vistorx/CatWandConnect/docs/home-assistant.fr.md

# Configurer Home Assistant

Ce guide facultatif ajoute le robot à Home Assistant, avec un tableau de bord tout prêt.

CatWandConnect fonctionne sans Home Assistant. Si tu l'utilises, le robot peut y apparaître comme un appareil avec un interrupteur de session de jeu, sa durée et l'heure à laquelle elle se termine, un bouton Ranger, son activité, et la position et la vitesse maximale de chaque axe, prêt pour tes tableaux de bord et tes automatisations.

Il y a deux façons de le connecter. Choisis-en une, configure-la, puis copie le [tableau de bord tout prêt](#tableaux-de-bord-tout-prêts) qui va avec.

## Ce qu'il te faut

| Quoi | Remarques |
|---|---|
| Un Home Assistant qui tourne | 2026.10 ou plus récent pour l'intégration native ; n'importe quelle version récente pour la connexion MQTT. |
| HACS, ou un broker MQTT | [HACS](https://hacs.xyz/) pour l'intégration native, ou un broker MQTT (l'app Mosquitto broker) pour la connexion MQTT. |
| Le robot sur ton Wi-Fi | Installé à l'[étape 3](install.fr.md), sur le même réseau que Home Assistant. |

Rien à acheter pour cette étape. **[Liste complète des pièces →](bom.fr.md)**

<!-- video: connecting the robot to Home Assistant -->
Photos et vidéo bientôt.

## Choisir ta connexion

| | Intégration native | Connexion MQTT |
|---|---|---|
| **Comment ça marche** | Home Assistant trouve le robot sur ton réseau et lui parle directement. | Le robot et Home Assistant s'échangent des messages par un *broker* MQTT qui tourne à côté de Home Assistant. |
| **Il te faut** | [HACS](https://hacs.xyz/), Home Assistant 2026.10 ou plus récent, le firmware 0.2.0-beta.2 ou plus récent sur le robot. | Un broker MQTT (l'application Mosquitto broker). Marche avec tout Home Assistant récent et toutes les versions du firmware. |
| **Installation** | 5 minutes environ : installer depuis HACS, cliquer sur **Ajouter** (et saisir le code PIN des réglages s'il y en a un). | Une dizaine de minutes : installer le broker, créer un utilisateur, ajouter l'intégration MQTT, saisir le broker dans le robot. |
| **Noms des entités** | Dans la langue de Home Assistant (français ou anglais). | En anglais. |
| **Idéal pour** | La plupart des propriétaires, surtout si tu n'utilises pas MQTT. | Ceux qui utilisent déjà MQTT (Zigbee2MQTT, Tasmota…), ou qui ne veulent pas de HACS. |

Les deux donnent les mêmes entités, suivent les mêmes règles de sécurité et restent sur ton réseau local, sans cloud. La connexion MQTT ne va pas disparaître : si elle marche déjà chez toi, garde-la.

> [!WARNING]
> N'utilise qu'une seule connexion par robot. Avec les deux, Home Assistant affiche le robot deux fois, comme deux appareils, et le second jeu d'entités reçoit des identifiants qui finissent par `_2` (`button.catwandconnect_stow_2`), que les tableaux de bord tout prêts et les automatisations ci-dessous n'utilisent pas. Pour changer, retire d'abord l'ancienne : pour la connexion MQTT, décoche **Activé** dans Réglages → Réseau → Home Assistant sur le robot, puis supprime l'appareil dans Home Assistant ; pour l'intégration native, supprime son entrée dans **Paramètres → Appareils et services → CatWandConnect**.

## Intégration native

L'intégration native s'installe avec [HACS](https://hacs.xyz/), la boutique communautaire de Home Assistant, depuis son propre dépôt, [`vistorx/ha-catwandconnect`](https://github.com/vistorx/ha-catwandconnect). Elle ne demande ni broker ni utilisateur en plus.

### Avant de commencer

- **Home Assistant 2026.10 ou plus récent** : **Paramètres → À propos** affiche la version.
- **HACS installé** : si **HACS** n'est pas dans la barre latérale de Home Assistant, suis d'abord le [guide d'installation de HACS](https://hacs.xyz/docs/use/) (en anglais).
- Le robot **installé et sur ton Wi-Fi** ([Installer le logiciel](install.fr.md)), sur le même réseau que Home Assistant, avec le **firmware 0.2.0-beta.2 ou plus récent** : sa page Infos (Réglages → Robot → Infos) affiche la version. Pour le mettre à jour, voir [Mettre à jour](install.fr.md#mettre-à-jour-compiler-depuis-les-sources).
- Un compte **administrateur** dans Home Assistant.

### 1. Installer l'intégration depuis HACS

1. Ouvre **HACS** dans la barre latérale.
2. Clique sur les trois points en haut à droite → **Dépôts personnalisés**.
3. Remplis :
   - **Dépôt** : `https://github.com/vistorx/ha-catwandconnect` ;
   - **Type** : **Intégration**.
4. Clique sur **Ajouter**, puis ferme la fenêtre.
5. Cherche **CatWandConnect** dans HACS, ouvre-le et clique sur **Télécharger**, puis encore sur **Télécharger** pour confirmer la version.
6. Redémarre Home Assistant : **Paramètres → Système**, l'icône d'alimentation en haut à droite → **Redémarrer Home Assistant**. (HACS affiche aussi une réparation *Redémarrage requis* dans **Paramètres**.)

HACS te propose tout seul les mises à jour de l'intégration quand une nouvelle version sort.

<!-- screenshot: Intégration native, step 1 -->

### 2. Ajouter le robot

1. Va dans **Paramètres → Appareils et services**.
2. En général, le robot attend sous *Découverts*, sous son nom : clique sur **Ajouter**, puis **Valider**.
3. S'il n'y est pas : **Ajouter une intégration** en bas à droite, cherche **CatWandConnect**, et saisis l'adresse du robot : son adresse `.local` (affichée dans Réglages → Réseau, par exemple `catwandconnect-3f9a.local`) ou son adresse IP, par exemple `192.168.1.20`.
4. **Code PIN des réglages** : si tu en as défini un dans les Réglages du robot, Home Assistant le demande une fois. Sans code PIN, il n'y a rien à saisir. Un code incorrect est signalé et tu peux réessayer ; après trop d'essais, attends le temps affiché.
5. Choisis une pièce si tu veux, puis **Terminer**.

Si le firmware du robot est trop ancien, l'ajout s'arrête avec *Le firmware de ce robot est trop ancien pour l'intégration* : [mets le robot à jour](install.fr.md#mettre-à-jour-compiler-depuis-les-sources) en 0.2.0-beta.2 ou plus récent, puis ajoute-le à nouveau.

Le robot n'est ajouté qu'une fois, même s'il est découvert de nouveau ; quand ta box lui donne une nouvelle adresse IP, l'intégration le suit.

<!-- screenshot: Intégration native, step 2 -->

### 3. Vérifier ses entités

Va dans **Paramètres → Appareils et services → CatWandConnect**, puis sur l'appareil du robot. Sa page liste ces entités, nommées dans la langue de Home Assistant :

| Entité | Type | Rôle |
|---|---|---|
| Ranger | Bouton | Range la baguette et relâche les servos. Passe avant toute autre commande. |
| Position horizontale, Position verticale | Nombre (degrés) | Indique où se trouve chaque axe. Changer la valeur déplace l'axe à cet endroit, à la vitesse du pilotage manuel, dans les limites de course. |
| Vitesse maximale horizontale, Vitesse maximale verticale | Nombre (10–360 °/s) | Le même réglage que dans les Réglages du robot. Une vitesse maximale inférieure ou égale à la vitesse minimale ramène la minimale au dixième de la nouvelle maximale. |
| Activité | Capteur | `idle`, `manual`, `stowing`, `calibrating`, `tuning_speed` ou `playing` (affichés *Au repos*, *Pilotage manuel*… à l'écran). |
| Session de jeu | Interrupteur | Allumé, il lance une session de jeu pour la durée de session ; éteint, il l'arrête et range la baguette. Il est allumé tant qu'une session tourne, qu'elle ait été lancée depuis Home Assistant ou depuis l'interface du robot, et s'éteint tout seul à la fin de la session. Refusé, avec un message qui dit pourquoi, tant que le robot n'est pas calibré, et pendant un rangement, une calibration ou un réglage de vitesse. |
| Durée de session | Nombre (1–60 min) | La durée de la prochaine session de jeu, la même valeur que sur l'écran principal du robot. |
| Fin de la session de jeu | Capteur (horodatage) | Le moment où la session de jeu en cours se termine, affiché « dans 7 minutes » : Home Assistant fait le décompte tout seul. Suit chaque session, lancée depuis Home Assistant ou depuis l'interface du robot. *Inconnu* quand aucune session ne tourne. Demande une intégration plus récente que la 0.2.0. |
| Session de jeu | Événement | Se déclenche à chaque événement de session de jeu : `started` (démarrée), `ended` (la durée de session est écoulée), `stopped` (arrêtée avant la fin) ou `refused` (refusée), avec les attributs `source` (`device_interface`, `home_assistant_mqtt`, `home_assistant_native`) et `reason` (pour `stopped` : `stop`, `stow`, `manual_control`, `calibration`, `speed_tuning` ; pour `refused` : `busy`, `not_calibrated`). Infos → Journal, sur le robot, affiche les 50 derniers. Intégration 0.3.0 ou plus récente, avec un firmware qui a le journal ; avec un firmware plus ancien, elle n'est pas créée. |
| Sessions aujourd'hui | Capteur | Combien de sessions de jeu ont démarré depuis minuit. Inconnu tant que le robot n'a pas l'heure : l'intégration lui donne celle de Home Assistant en se connectant. |
| Firmware | Mise à jour | La version installée et, quand une plus récente sort sur le Canal de mise à jour du robot, la dernière version avec ses nouveautés. Home Assistant affiche alors sa notification de mise à jour habituelle ; **Installer** télécharge le bon fichier et met le robot à jour (intégration 0.2.0 ou plus récente). Refusé pendant une session de jeu ou une calibration. |

Les entités se mettent à jour en moins d'une seconde quand quelqu'un utilise le joystick ou l'écran du robot. Quand le robot est éteint ou perd le Wi-Fi, elles apparaissent comme indisponibles, et reviennent toutes seules à son retour. La page de l'appareil montre aussi le modèle, la puce et la version du firmware du robot, et un lien **Visiter** vers son interface.

**Quand tu changes le code PIN du robot**, Home Assistant te demande le nouveau : le robot apparaît en haut de **Paramètres → Appareils et services** avec **Reconfigurer**. Clique dessus et saisis le nouveau code PIN.

Les commandes venant de Home Assistant suivent les mêmes règles de sécurité que le téléphone : limites de course, limites de vitesse et priorités. Rien depuis Home Assistant ne peut pousser la baguette au-delà de ses limites, et le rangement ne peut pas être interrompu.

<!-- screenshot: Intégration native, step 3 -->

## Connexion MQTT

Le robot parle à Home Assistant par **MQTT**, un petit service de messages qui tourne à côté de Home Assistant (le *broker*). Le robot y envoie son état et y reçoit ses commandes ; Home Assistant lit et écrit les mêmes messages. Compte une dizaine de minutes :

1. [Vérifier les prérequis](#1-vérifier-les-prérequis)
2. [Installer le broker MQTT](#2-installer-le-broker-mqtt)
3. [Créer un utilisateur pour le robot](#3-créer-un-utilisateur-pour-le-robot)
4. [Ajouter l'intégration MQTT](#4-ajouter-lintégration-mqtt)
5. [Connecter le robot](#5-connecter-le-robot)
6. [Le retrouver dans Home Assistant](#6-le-retrouver-dans-home-assistant)

Tu utilises déjà MQTT (Zigbee2MQTT, Tasmota…) ? Ton broker et ton intégration sont prêts : crée un utilisateur (étape 3) et passe à l'[étape 5](#5-connecter-le-robot).

### 1. Vérifier les prérequis

- **Home Assistant OS** (un Home Assistant Green ou Yellow, un Raspberry Pi, une machine virtuelle). Pour le vérifier : **Paramètres → À propos**, ligne *Type d'installation*. Sur **Home Assistant Container** ou **Core**, il n'y a pas de menu *Applications* : installe toi-même un broker Mosquitto (par exemple son image Docker) et passe à l'[étape 4](#4-ajouter-lintégration-mqtt).
- Un compte **administrateur** dans Home Assistant.
- Le robot **installé et sur ton Wi-Fi** ([Installer le logiciel](install.fr.md)), sur le même réseau que Home Assistant.
- L'**adresse IP** de Home Assistant : **Paramètres → Système → Réseau**, sous *Adaptateur réseau*, par exemple `192.168.1.124`. Note-la pour l'étape 5. Donne-lui une adresse fixe dans ta box (une *réservation DHCP*) pour qu'elle ne change jamais.

<!-- screenshot: Connexion MQTT, step 1 -->

### 2. Installer le broker MQTT

1. Dans Home Assistant, va dans **Paramètres → Applications → Installer une application** (appelées *Modules complémentaires* avant Home Assistant 2026.2).
2. Cherche **Mosquitto broker** et ouvre-le.
3. Clique sur **Installer**, patiente, puis active **Démarrer au démarrage** et clique sur **Démarrer**.
4. Ouvre l'onglet **Journal** : au bout de quelques secondes, il doit se terminer sans erreur.

Laisse son onglet *Configuration* tel quel : le broker accepte les utilisateurs de Home Assistant, c'est ce qu'utilise l'étape 3.

<!-- screenshot: Connexion MQTT, step 2 -->

### 3. Créer un utilisateur pour le robot

Le broker refuse les connexions anonymes : le robot a besoin de son propre identifiant.

1. Active le **Mode avancé** : clique sur ton nom en bas à gauche, puis active *Mode avancé* (sinon l'onglet *Utilisateurs* est caché).
2. Va dans **Paramètres → Personnes → Utilisateurs** et clique sur **Ajouter un utilisateur**.
3. Remplis :
   - **Nom d'affichage** : `CatWandConnect` ;
   - **Nom d'utilisateur** : `catwandconnect` (pas `homeassistant` ni `addons` : le broker les réserve) ;
   - **Mot de passe** : un nouveau mot de passe, utilisé seulement par le robot. Note-le pour l'étape 5.
4. Laisse **Administrateur** désactivé, puis clique sur **Créer**.

Cet utilisateur ne se connecte jamais à l'interface de Home Assistant ; il permet seulement au robot de parler au broker.

<!-- screenshot: Connexion MQTT, step 3 -->

### 4. Ajouter l'intégration MQTT

C'est ce qui relie Home Assistant lui-même au broker.

1. Va dans **Paramètres → Appareils et services**.
2. En général, **MQTT** attend sous *Découverts* : clique sur **Ajouter**, puis **Valider**.
3. S'il n'y est pas : **Ajouter une intégration** en bas à droite, cherche **MQTT**, choisis **MQTT**, et confirme le broker Mosquitto.
4. **MQTT** apparaît maintenant dans la liste des intégrations, sans erreur.

Laisse *Activer la découverte* coché et le préfixe de découverte à `homeassistant` (les valeurs par défaut) : c'est là que le robot s'annonce.

<!-- screenshot: Connexion MQTT, step 4 -->

### 5. Connecter le robot

1. Ouvre l'interface du robot (son adresse `.local` ou son IP), puis **Réglages → Réseau → Home Assistant**.
2. Coche **Activé**, et remplis :
   - **Broker** : l'adresse IP de Home Assistant notée à l'étape 1, par exemple `192.168.1.124`. `homeassistant.local` marche aussi sur la plupart des réseaux, mais l'IP est plus fiable ;
   - **Port** : `1883` ;
   - **Utilisateur** et **Mot de passe** : l'utilisateur de l'étape 3.
3. Clique sur **Enregistrer**. Si un code PIN des réglages est défini, le robot le demande.
4. En quelques secondes, **État** indique **Connecté**. S'il affiche une erreur, voir [Dépannage de la connexion MQTT](#dépannage-de-la-connexion-mqtt).

Le robot se reconnecte tout seul après une coupure de courant ou un redémarrage de Home Assistant.

<!-- screenshot: Connexion MQTT, step 5 -->

### 6. Le retrouver dans Home Assistant

Va dans **Paramètres → Appareils et services → MQTT**, puis **Appareils**. Le robot apparaît sous son nom, avec les mêmes entités qu'avec l'intégration native ([listées plus haut](#3-vérifier-ses-entités)), mais nommées en anglais : Stow, Horizontal position, Vertical position, Horizontal maximum speed, Vertical maximum speed, Activity, Play session (interrupteur et événement), Session duration, Sessions today, Firmware et Play session end. Les différences :

- Horizontal position et Vertical position vont de 0 à 180° ; le robot garde l'axe dans ses limites de course.
- Une session de jeu refusée par le robot (pas calibré, occupé) remet l'interrupteur sur éteint sans message ; l'événement Play session se déclenche avec `refused` et la raison, et Infos → Journal, sur le robot, l'affiche.
- **Sessions today** reste inconnu après un redémarrage du robot tant que personne n'a ouvert sa page : en MQTT, le robot ne reçoit l'heure que du navigateur du téléphone.
- Session duration est mémorisée dès que le robot est au repos.
- Play session end (`sensor.catwandconnect_play_session_end`) est calculé par Home Assistant : le robot n'a pas d'horloge, il envoie donc le temps restant quand une session commence ou se termine, et Home Assistant l'ajoute à sa propre heure. Demande un firmware plus récent que la 0.2.1.
- **Firmware** (`update.catwandconnect_firmware`) affiche la version installée et, dès que la page du robot en a trouvé une plus récente pour son Canal de mise à jour, la dernière version avec un lien vers ses nouveautés : Home Assistant affiche alors sa notification de mise à jour habituelle. Il n'y a pas de bouton **Installer** : le robot ne peut rien télécharger lui-même. Mets à jour depuis la page du robot (le bouton **Mettre à jour** de son écran principal, voir [Mettre à jour](install.fr.md#mettre-à-jour-compiler-depuis-les-sources)) ou avec l'intégration native. La dernière version est connue après que quelqu'un a ouvert la page du robot, et oubliée quand le robot redémarre.

Quand le robot est éteint ou perd le Wi-Fi, ses entités apparaissent comme indisponibles.

<!-- screenshot: Connexion MQTT, step 6 -->

## Tableaux de bord tout prêts

Un panneau de contrôle pour le robot : un grand bouton de session de jeu (appuie pour lancer, appuie encore pour arrêter) et sa durée, Ranger, l'activité et, pendant une session, l'heure à laquelle elle se termine, la position et la vitesse maximale de chaque axe, et un bouton **Page du robot** qui ouvre la page du robot lui-même. Un appui long sur n'importe laquelle de ses cartes ouvre aussi la page du robot. Il y en a un pour chaque connexion. Celui de l'intégration native ajoute la carte joystick fournie par l'intégration ; celui de la connexion MQTT n'utilise que des cartes intégrées à Home Assistant.

1. Va dans **Paramètres → Tableaux de bord → Ajouter un tableau de bord → Nouveau tableau de bord à partir de zéro**, nomme-le, par exemple « Canne à chat », et ouvre-le.
2. Clique sur le crayon (**Modifier le tableau de bord**), puis sur les trois points → **Éditeur de configuration brute**.
3. Remplace tout par le YAML de ta connexion ci-dessous.
4. Remplace chaque `http://catwandconnect.local/` par l'adresse de ton robot (rechercher et remplacer dans l'éditeur), puis **Enregistre**. L'adresse est sur la page du robot, dans **Réglages → Réseau → Wi-Fi** : par exemple `http://catwandconnect-3f9a.local/` avec le nom par défaut. Les robots installés avant la version 0.2.1 gardent `http://catwandconnect.local/` : rien à remplacer. C'est cette adresse qu'ouvrent le bouton **Page du robot** et les appuis longs ; la page de l'appareil dans Home Assistant a aussi un lien **Visiter** vers elle.

Sur un téléphone, les sections s'empilent : la session de jeu d'abord, puis les positions et les vitesses. Pour ajouter les cartes à un tableau de bord existant, copie seulement les trois sections `- type: grid` dans une de ses vues en sections.

**Robot renommé ?** Les identifiants ci-dessous sont ceux d'un robot qui a le nom par défaut. Les identifiants des entités suivent le nom du robot : pour un robot nommé « CatWandConnect salon », remplace chaque `catwandconnect_` par `catwandconnect_salon_` (rechercher et remplacer dans l'éditeur). Les identifiants exacts sont sur la page de l'appareil, dans **Paramètres → Appareils et services**, puis **CatWandConnect** ou **MQTT**.

### Tableau de bord pour l'intégration native

Le tableau de bord de l'intégration native : session de jeu, durée et Ranger, la carte joystick, positions et vitesses maximales

<!-- ha-dashboard-native -->
```yaml
title: Canne à chat
views:
  - title: Canne à chat
    path: catwandconnect
    type: sections
    max_columns: 3
    sections:
      - type: grid
        cards:
          - type: heading
            heading: Session de jeu
            icon: mdi:cat
            badges:
              - type: entity
                entity: sensor.catwandconnect_activity
                show_state: true
              - type: entity
                entity: sensor.catwandconnect_play_session_end
                show_state: true
                visibility:
                  - condition: state
                    entity: sensor.catwandconnect_play_session_end
                    state_not: [unknown, unavailable]
              - type: entity
                entity: update.catwandconnect_firmware
                show_state: true
                visibility:
                  - condition: state
                    entity: update.catwandconnect_firmware
                    state: "on"
              - type: button
                icon: mdi:open-in-new
                text: Page du robot
                tap_action:
                  action: url
                  url_path: http://catwandconnect.local/
          - type: button
            entity: switch.catwandconnect_play_session
            name: Session de jeu
            icon: mdi:play-circle-outline
            show_state: false
            icon_height: 64px
            tap_action:
              action: toggle
            hold_action:
              action: url
              url_path: http://catwandconnect.local/
          - type: tile
            entity: number.catwandconnect_session_duration
            name: Durée de session
            features:
              - type: numeric-input
                style: buttons
            features_position: inline
            hold_action:
              action: url
              url_path: http://catwandconnect.local/
          - type: tile
            entity: button.catwandconnect_stow
            name: Ranger
            color: red
            tap_action:
              action: perform-action
              perform_action: button.press
              target:
                entity_id: button.catwandconnect_stow
            hold_action:
              action: url
              url_path: http://catwandconnect.local/
      - type: grid
        cards:
          - type: heading
            heading: Position
            icon: mdi:axis-arrow
          - type: custom:catwandconnect-joystick-card
            entity: sensor.catwandconnect_activity
          - type: tile
            entity: number.catwandconnect_horizontal_position
            name: Horizontal
            features:
              - type: numeric-input
                style: slider
            hold_action:
              action: url
              url_path: http://catwandconnect.local/
          - type: tile
            entity: number.catwandconnect_vertical_position
            name: Vertical
            features:
              - type: numeric-input
                style: slider
            hold_action:
              action: url
              url_path: http://catwandconnect.local/
      - type: grid
        cards:
          - type: heading
            heading: Vitesse maximale
            icon: mdi:speedometer
          - type: tile
            entity: number.catwandconnect_horizontal_maximum_speed
            name: Horizontal
            features:
              - type: numeric-input
                style: buttons
            features_position: inline
            hold_action:
              action: url
              url_path: http://catwandconnect.local/
          - type: tile
            entity: number.catwandconnect_vertical_maximum_speed
            name: Vertical
            features:
              - type: numeric-input
                style: buttons
            features_position: inline
            hold_action:
              action: url
              url_path: http://catwandconnect.local/
```

Le joystick marche comme celui de la page du robot : maintiens et fais glisser, la baguette suit ; lâche, elle s'arrête. Il est fourni par l'intégration (0.1.1 ou plus récente) : rien à ajouter dans *Ressources*. S'il affiche « Custom element doesn't exist », recharge la page (tire vers le bas dans l'appli) après la mise à jour. Les curseurs de position vont d'une limite de course à l'autre.

**Tu as ajouté le robot avec l'intégration 0.1.0, avec Home Assistant dans une autre langue que l'anglais ?** Ses identifiants sont dans cette langue (`switch.catwandconnect_session_de_jeu`) et les cartes affichent « Entité non disponible ». Supprime le robot dans **Paramètres → Appareils et services → CatWandConnect** et ajoute-le de nouveau (à partir de la 0.1.1, les identifiants sont toujours en anglais), ou remplace les identifiants du YAML par les tiens, visibles sur la page de l'appareil.

### Tableau de bord pour la connexion MQTT

Le tableau de bord de la connexion MQTT : session de jeu, durée et Ranger, positions et vitesses maximales

<!-- ha-dashboard -->
```yaml
title: Canne à chat
views:
  - title: Canne à chat
    path: catwandconnect
    type: sections
    max_columns: 3
    sections:
      - type: grid
        cards:
          - type: heading
            heading: Session de jeu
            icon: mdi:cat
            badges:
              - type: entity
                entity: sensor.catwandconnect_activity
                show_state: true
              - type: entity
                entity: sensor.catwandconnect_play_session_end
                show_state: true
                visibility:
                  - condition: state
                    entity: sensor.catwandconnect_play_session_end
                    state_not: [unknown, unavailable]
              - type: entity
                entity: update.catwandconnect_firmware
                show_state: true
                visibility:
                  - condition: state
                    entity: update.catwandconnect_firmware
                    state: "on"
              - type: button
                icon: mdi:open-in-new
                text: Page du robot
                tap_action:
                  action: url
                  url_path: http://catwandconnect.local/
          - type: button
            entity: switch.catwandconnect_play_session
            name: Session de jeu
            icon: mdi:play-circle-outline
            show_state: false
            icon_height: 64px
            tap_action:
              action: toggle
            hold_action:
              action: url
              url_path: http://catwandconnect.local/
          - type: tile
            entity: number.catwandconnect_session_duration
            name: Durée de session
            features:
              - type: numeric-input
                style: buttons
            features_position: inline
            hold_action:
              action: url
              url_path: http://catwandconnect.local/
          - type: tile
            entity: button.catwandconnect_stow
            name: Ranger
            color: red
            tap_action:
              action: perform-action
              perform_action: button.press
              target:
                entity_id: button.catwandconnect_stow
            hold_action:
              action: url
              url_path: http://catwandconnect.local/
      - type: grid
        cards:
          - type: heading
            heading: Position
            icon: mdi:axis-arrow
          - type: tile
            entity: number.catwandconnect_horizontal_position
            name: Horizontal
            features:
              - type: numeric-input
                style: slider
            hold_action:
              action: url
              url_path: http://catwandconnect.local/
          - type: tile
            entity: number.catwandconnect_vertical_position
            name: Vertical
            features:
              - type: numeric-input
                style: slider
            hold_action:
              action: url
              url_path: http://catwandconnect.local/
      - type: grid
        cards:
          - type: heading
            heading: Vitesse maximale
            icon: mdi:speedometer
          - type: tile
            entity: number.catwandconnect_horizontal_maximum_speed
            name: Horizontal
            features:
              - type: numeric-input
                style: buttons
            features_position: inline
            hold_action:
              action: url
              url_path: http://catwandconnect.local/
          - type: tile
            entity: number.catwandconnect_vertical_maximum_speed
            name: Vertical
            features:
              - type: numeric-input
                style: buttons
            features_position: inline
            hold_action:
              action: url
              url_path: http://catwandconnect.local/
```

Les curseurs de position vont de 0 à 180° ; le robot s'arrête à ses limites de course. Un badge **Firmware** apparaît à côté d'Activity quand une nouvelle version est disponible ; touche-le pour voir les nouveautés. La carte joystick n'existe qu'avec l'intégration native ; avec la connexion MQTT, déplace la baguette avec les curseurs ou depuis la page du robot.

## Automatisations

Dans **Paramètres → Automatisations et scènes → Créer une automatisation → Créer une nouvelle automatisation**, trois points → **Modifier en YAML**, colle l'un de ces exemples, puis **Enregistrer**. Ils marchent avec les deux connexions.

Ranger la baguette tous les soirs à 22 h :

```yaml
alias: Ranger la canne à chat le soir
triggers:
  - trigger: time
    at: "22:00:00"
actions:
  - action: button.press
    target:
      entity_id: button.catwandconnect_stow
```

Lancer une session de jeu de 15 minutes quand tu pars au travail en semaine :

```yaml
alias: Jouer avec le chat après notre départ
triggers:
  - trigger: time
    at: "08:30:00"
conditions:
  - condition: time
    weekday: [mon, tue, wed, thu, fri]
actions:
  - action: number.set_value
    target:
      entity_id: number.catwandconnect_session_duration
    data:
      value: 15
  - action: switch.turn_on
    target:
      entity_id: switch.catwandconnect_play_session
```

Recevoir une notification quand une session de jeu est refusée, avec la raison :

```yaml
alias: Prévenir quand la baguette refuse de jouer
triggers:
  - trigger: state
    entity_id: event.catwandconnect_play_session
conditions:
  - condition: template
    value_template: "{{ trigger.to_state.attributes.event_type == 'refused' }}"
actions:
  - action: notify.notify
    data:
      message: >-
        La baguette a refusé de jouer ({{ trigger.to_state.attributes.reason }}).
```

Les identifiants des entités suivent le nom du robot : `button.catwandconnect_stow` par défaut, `button.catwandconnect_salon_stow` pour un robot nommé « CatWandConnect salon ». Ils restent en anglais, et sont les mêmes avec les deux connexions ; des identifiants qui finissent par `_2` veulent dire que le robot est connecté deux fois (voir [Choisir ta connexion](#choisir-ta-connexion)). Les automatisations sur l'activité utilisent ses états `idle`, `manual`, `stowing`, `calibrating`, `tuning_speed` et `playing`, quelle que soit la langue dans laquelle Home Assistant les affiche. L'état d'une entité événement est l'heure de son dernier événement : déclenche sur tout changement et teste `event_type`, pour que deux refus de suite comptent tous les deux.

## Dépannage

### Dépannage de l'intégration native

| Problème | À vérifier |
|---|---|
| Le robot n'est pas sous *Découverts* | Ajoute-le à la main : **Ajouter une intégration → CatWandConnect**, avec son adresse IP (sur sa page Infos) ou son nom en `.local`. La découverte passe par le mDNS, qui ne traverse pas les réseaux : si Home Assistant et le robot sont sur des VLAN ou des sous-réseaux différents (un réseau IoT, un Wi-Fi invité), ajoute-le par son IP et donne au robot une adresse fixe dans ta box (une *réservation DHCP*), ou active un relais mDNS dans ton routeur. Sur Home Assistant Container, la découverte demande le réseau en mode hôte ; dans une machine virtuelle, une carte réseau en mode pont (pas en NAT). Un robot déjà ajouté n'y apparaît plus. Pour savoir si Home Assistant entend le robot, active **Activer la journalisation de débogage** sur la page de l'intégration CatWandConnect et redémarre-la : chaque annonce ajoute une ligne *Robot … announced at …* dans le journal. |
| *CatWandConnect* n'est pas dans **Ajouter une intégration** | Home Assistant n'a pas été redémarré après le téléchargement ([étape 1](#1-installer-lintégration-depuis-hacs)), ou HACS n'a rien téléchargé : ouvre HACS et vérifie que l'intégration apparaît comme téléchargée. Recharge ensuite la page du navigateur. |
| *Le firmware de ce robot est trop ancien pour l'intégration* | Le robot a un firmware plus ancien que 0.2.0-beta.2. [Mets-le à jour](install.fr.md#mettre-à-jour-compiler-depuis-les-sources), puis ajoute-le à nouveau. |
| Impossible de joindre le robot | Le robot est allumé, sur le même réseau que Home Assistant, et son interface s'ouvre dans un navigateur à l'adresse que tu as saisie. |
| Home Assistant redemande le code PIN | Le code PIN des réglages du robot a changé. Clique sur **Reconfigurer** et saisis le code PIN actuel. |
| Entités indisponibles | Le robot est éteint ou hors Wi-Fi. Elles reviennent toutes seules dans les 30 secondes environ qui suivent sa reconnexion. Si elles restent indisponibles, vérifie que l'interface du robot s'ouvre ; si son IP a changé et que la découverte ne le voit pas (autre VLAN), réserve son adresse dans ta box. |
| La session de jeu ne démarre pas | Home Assistant dit pourquoi : le robot n'est pas encore calibré, ou il est en train de se ranger, de se calibrer ou de régler une vitesse. Calibre-le depuis son écran principal. |

Pour un rapport de bug, ajoute les diagnostics de l'intégration : sur la page de l'appareil du robot, les trois points → **Télécharger les diagnostics**. Le nom de ton Wi-Fi, tes adresses et les détails du broker y sont masqués, comme dans le rapport de diagnostic.

### Dépannage de la connexion MQTT

| État dans les Réglages du robot | À vérifier |
|---|---|
| Broker injoignable | L'adresse du broker et le port `1883`, et que l'application Mosquitto broker est démarrée ([étape 2](#2-installer-le-broker-mqtt)). Mets l'IP de Home Assistant au lieu de `homeassistant.local`. |
| Le broker a refusé l'utilisateur ou le mot de passe | L'utilisateur et le mot de passe de l'[étape 3](#3-créer-un-utilisateur-pour-le-robot). Retape le mot de passe dans le robot (il n'affiche jamais celui enregistré). Le nom d'utilisateur ne peut pas être `homeassistant` ni `addons`. |
| Connecté, mais aucun appareil dans Home Assistant | L'intégration MQTT est installée ([étape 4](#4-ajouter-lintégration-mqtt)), avec la découverte activée et le préfixe `homeassistant`. |
| Entités indisponibles | Le robot est éteint ou hors Wi-Fi. Elles reviennent dans la minute qui suit sa reconnexion. |
| L'interrupteur de session de jeu revient sur éteint | Le robot n'est pas encore calibré, ou il est en train de se ranger, de se calibrer ou de régler une vitesse. Calibre-le depuis son écran principal. |

Les topics MQTT du robot sont documentés dans l'[API du robot](api.fr.md#home-assistant-mqtt). La page de l'appareil dans Home Assistant a un lien **Visiter** vers l'interface du robot (la découverte MQTT n'autorise qu'un lien par appareil, il ne peut donc pas pointer directement vers la page Aide).

### Toujours bloqué ?

Voir [Obtenir de l'aide](../SUPPORT.fr.md), ou ouvre **Aide** dans Réglages → Robot. Les bugs de l'intégration native se signalent aussi dans les [issues de CatWandConnect](https://github.com/vistorx/CatWandConnect/issues/new/choose) : choisis *Home Assistant integration (HACS)* comme domaine.

Ensuite : joue ! Toutes les fonctionnalités sont décrites dans [Fonctionnalités](features.fr.md).
