vistorx/CatWandConnect/media/discord/discord-admin-512.png

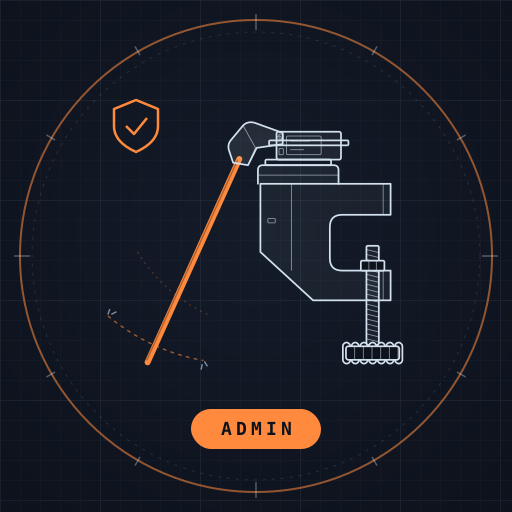
media/discord/discord-admin-512.png
