vistorx/CatWandConnect/media/social/social-preview.png

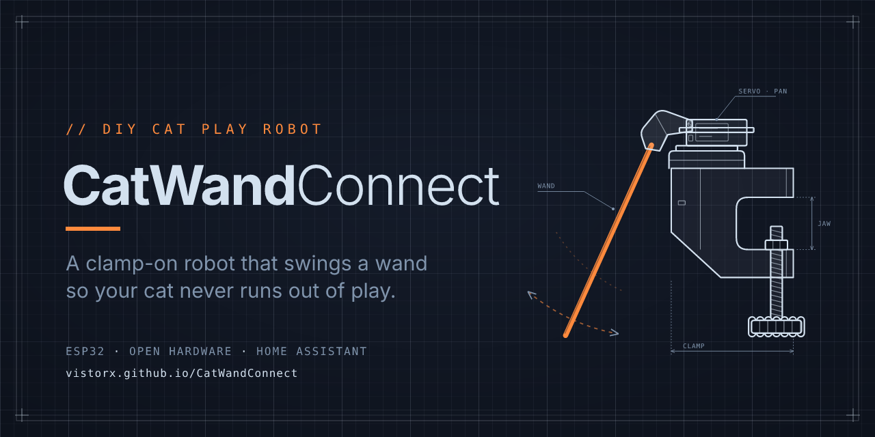
media/social/social-preview.png
