vistorx/CatWandConnect/media/video/mk2-presentation-poster.jpg

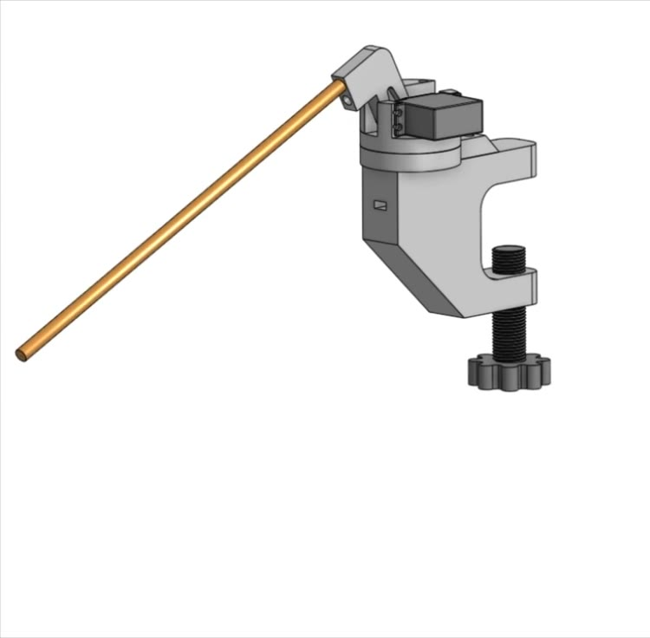
media/video/mk2-presentation-poster.jpg
