vistorx/CatWandConnect/stls/cat_playing_platform_V1/Stick support.stl

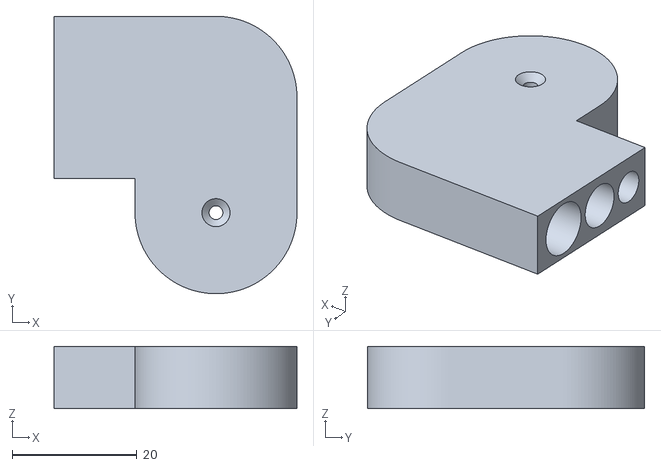
[picture p9: CAD file, 2026-10-08]
stls/cat_playing_platform_V1/Stick support.stl
39.0 x 44.5 x 10.0
