vistorx/CatWandConnect/stls/mk3/catwandconnect-mk3-clamp.stl

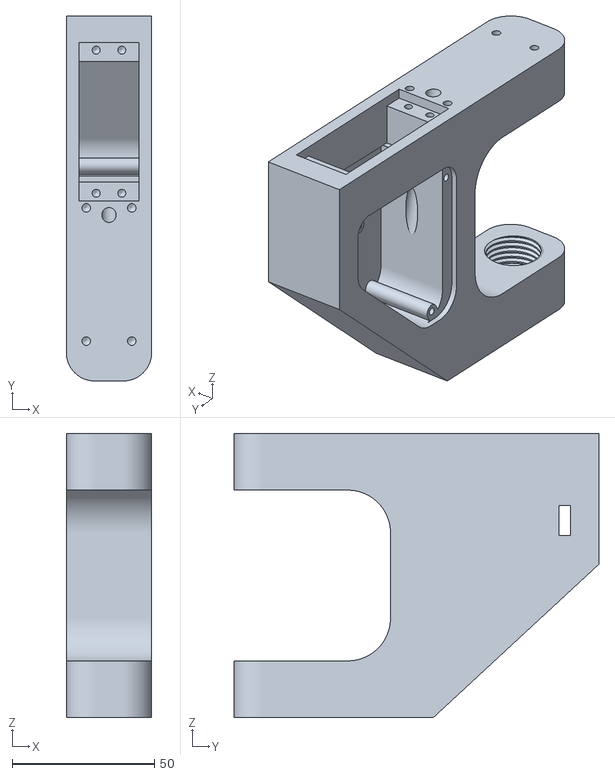
[picture p10: CAD file, 2026-10-18]
stls/mk3/catwandconnect-mk3-clamp.stl
30.0 x 128.3 x 100.0
