vistorx/CatWandConnect/cads/mk3/catwandconnect-mk3-arm.step

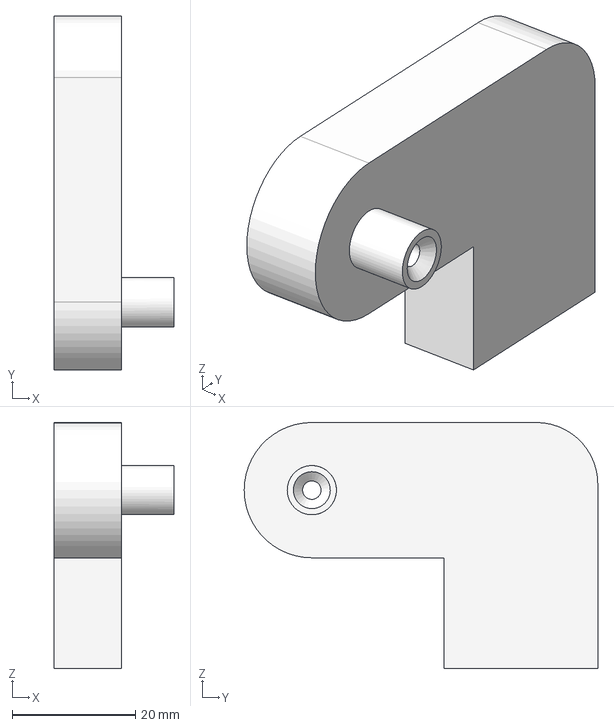
[picture p11: CAD file, 2026-10-20]
cads/mk3/catwandconnect-mk3-arm.step
19.5 x 57.5 x 40.0 mm
