vistorx/CatWandConnect/stls/cat_playing_platform_V1/CLAMP - Pad.stl

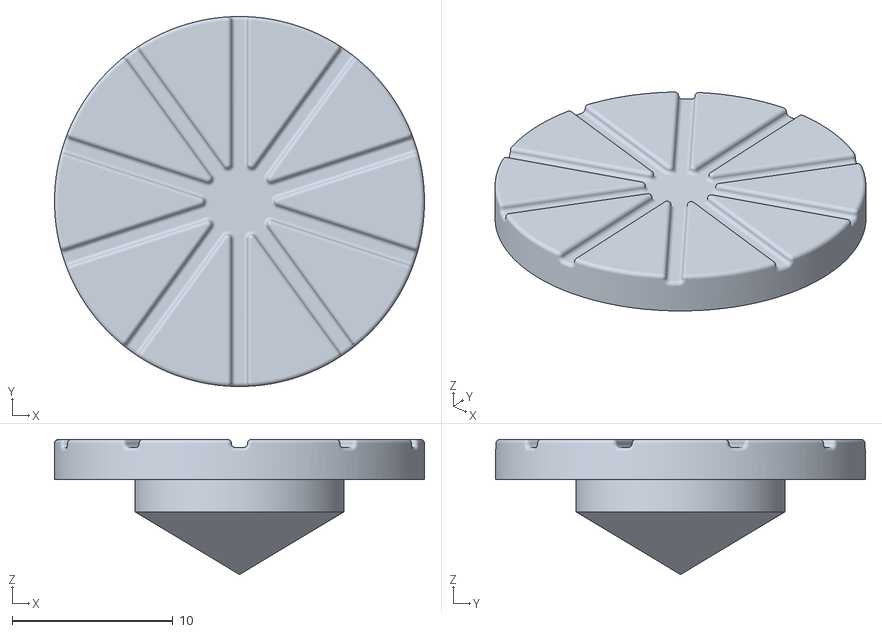
[picture p12: CAD file, 2026-10-08]
stls/cat_playing_platform_V1/CLAMP - Pad.stl
23.0 x 23.0 x 8.41
