vistorx/CatWandConnect/stls/mk3/catwandconnect-mk3.3mf

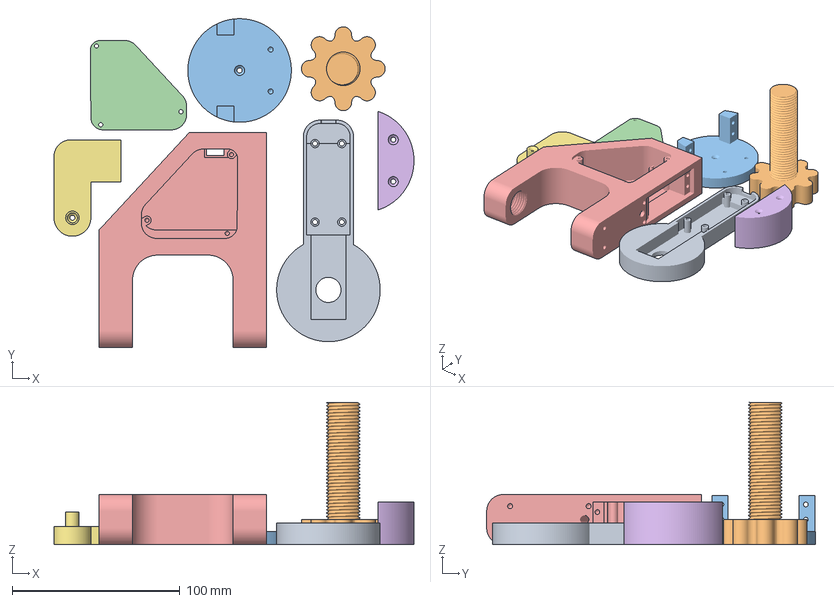
[picture p13: CAD file, 2026-10-18]
stls/mk3/catwandconnect-mk3.3mf
214.8 x 196.1 x 85.0 mm
catwandconnect-mk3-top_plate.stl
catwandconnect-mk3-screw.stl
catwandconnect-mk3-rotor_plate.stl
catwandconnect-mk3-door.stl
catwandconnect-mk3-clamp.stl
catwandconnect-mk3-bearing_holder.stl
catwandconnect-mk3-arm.stl
