vistorx/CatWandConnect/stls/cat_playing_platform_V1/Part Studio 1 - Part 2.stl

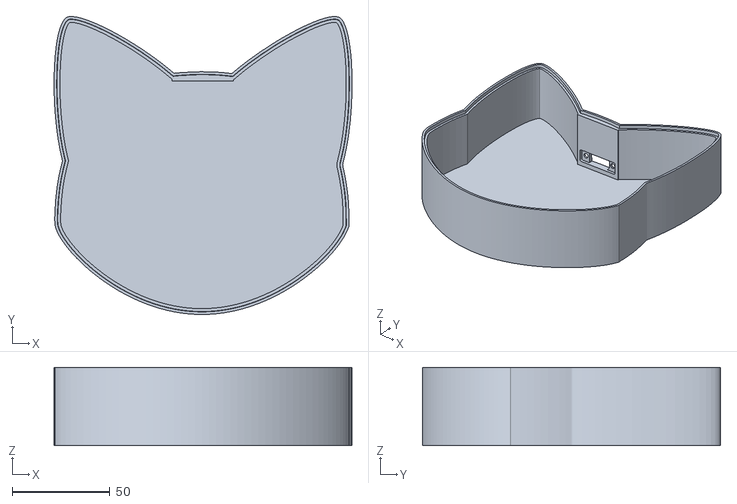
[picture p14: CAD file, 2026-10-08]
stls/cat_playing_platform_V1/Part Studio 1 - Part 2.stl
152.4 x 152.4 x 40.0
