vistorx/CatWandConnect/stls/mk3/catwandconnect-mk3-top_plate.stl

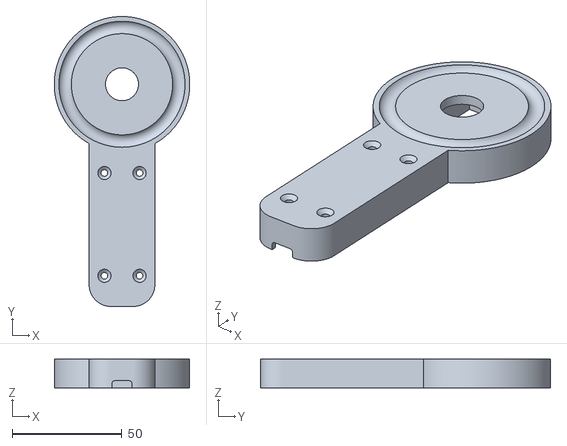
[picture p15: CAD file, 2026-10-18]
stls/mk3/catwandconnect-mk3-top_plate.stl
61.8 x 132.2 x 13.0
