vistorx/CatWandConnect/stls/cat_playing_platform_V1/Part Studio 1 - Part 3.stl

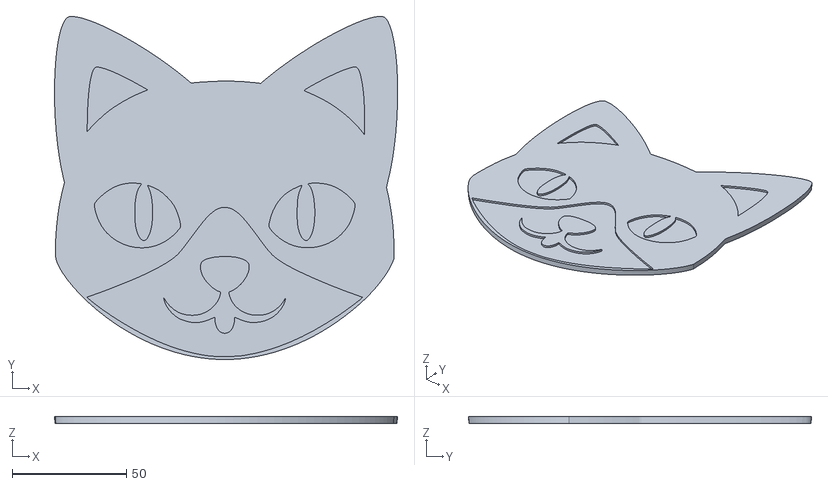
[picture p16: CAD file, 2026-10-08]
stls/cat_playing_platform_V1/Part Studio 1 - Part 3.stl
149.8 x 149.9 x 3.00
