vistorx/CatWandConnect/stls/mk3/catwandconnect-mk3-bearing_holder.stl

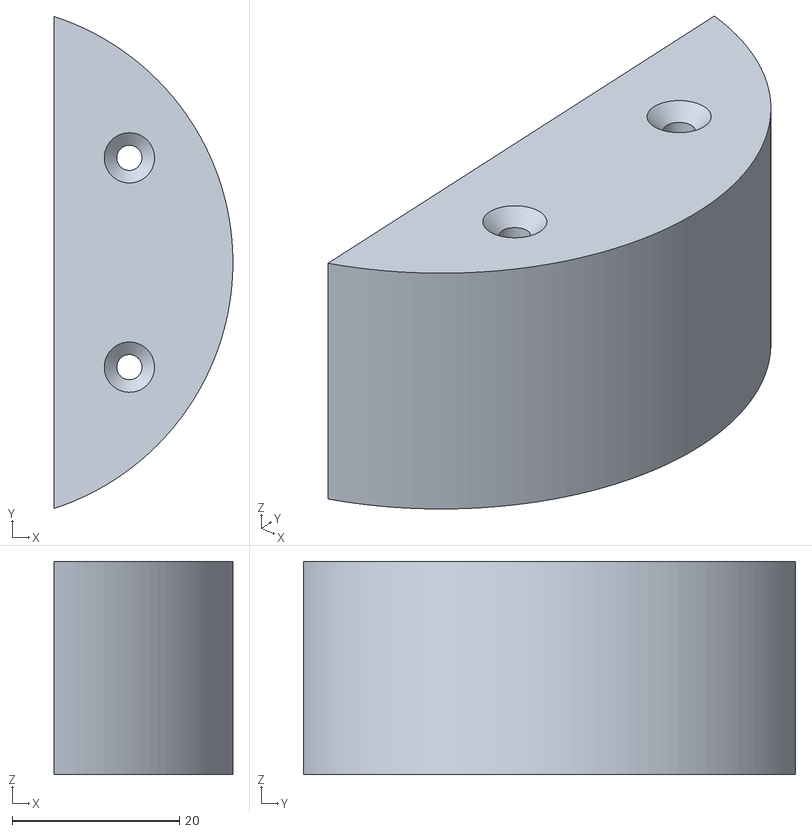
[picture p17: CAD file, 2026-10-17]
stls/mk3/catwandconnect-mk3-bearing_holder.stl
21.4 x 58.8 x 25.5
