vistorx/CatWandConnect/cads/mk3/catwandconnect-mk3-rotor_plate.step

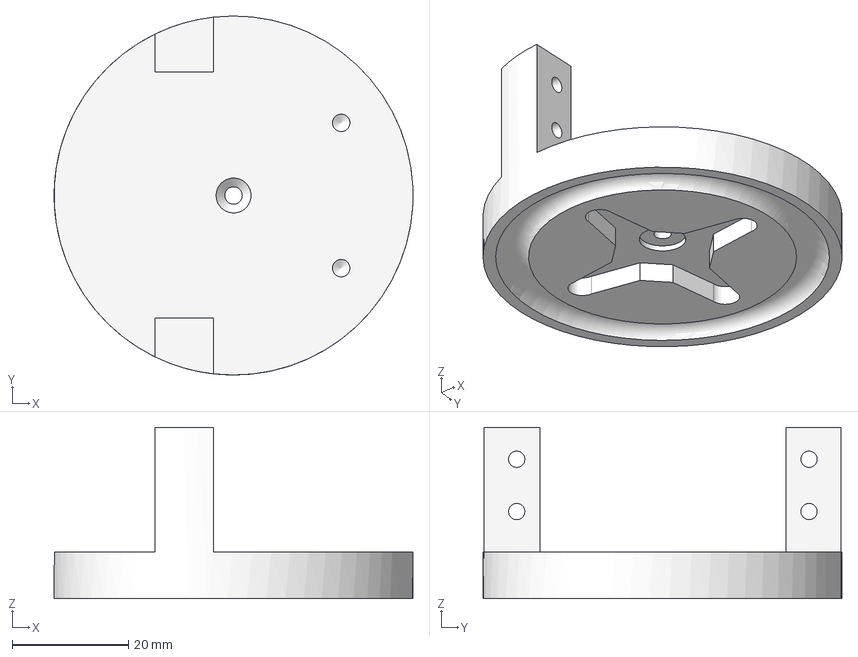
[picture p18: CAD file, 2026-10-20]
cads/mk3/catwandconnect-mk3-rotor_plate.step
61.8 x 61.8 x 29.5 mm
