vistorx/CatWandConnect/stls/cat_playing_platform_V1/CLAMP - Clamp.stl

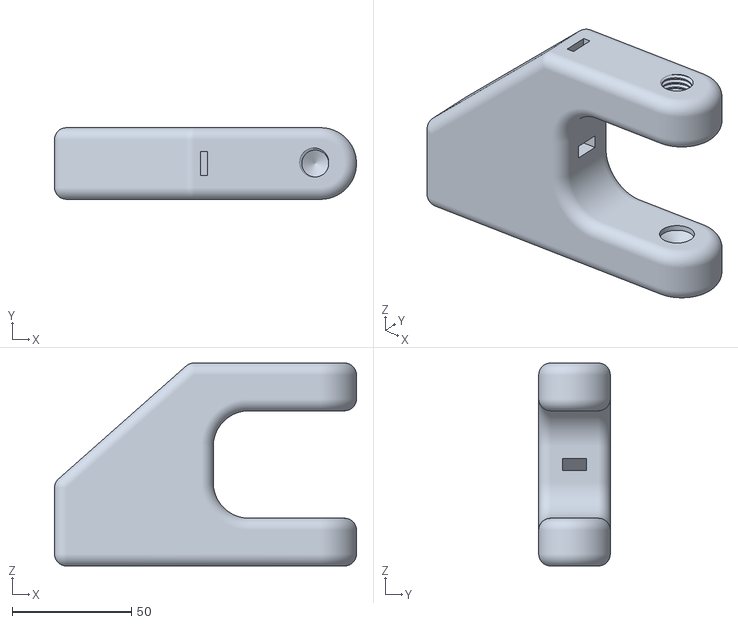
[picture p19: CAD file, 2026-10-08]
stls/cat_playing_platform_V1/CLAMP - Clamp.stl
126.5 x 30.0 x 85.0
