vistorx/CatWandConnect/stls/mk3/catwandconnect-mk3-door.stl

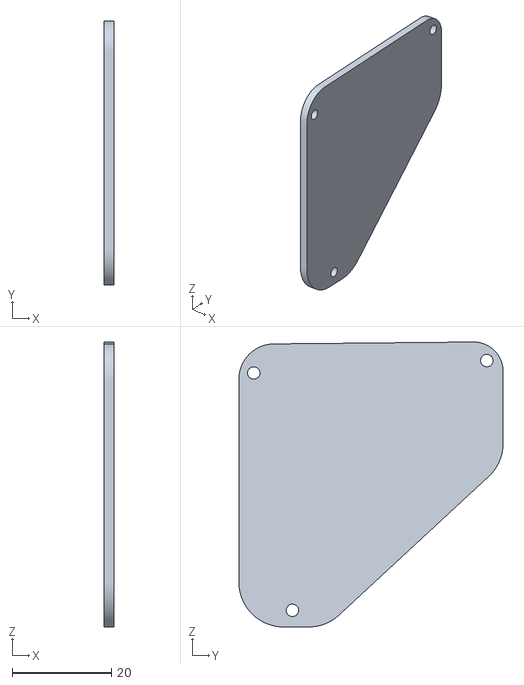
[picture p20: CAD file, 2026-10-17]
stls/mk3/catwandconnect-mk3-door.stl
2.00 x 53.3 x 57.5
