vistorx/CatWandConnect/cads/mk3/catwandconnect-mk3.step

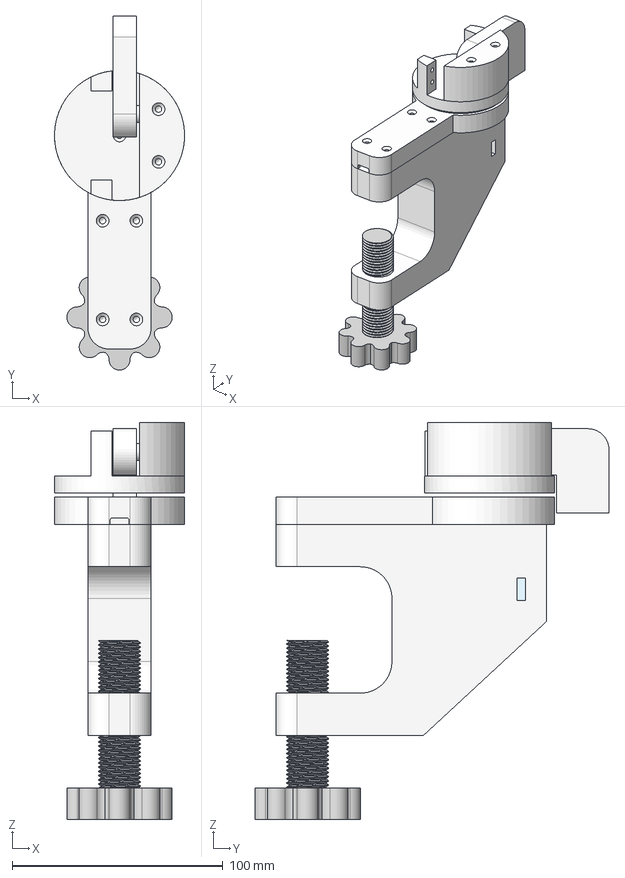
[picture p21: CAD file, 2026-10-20]
cads/mk3/catwandconnect-mk3.step
61.8 x 168.0 x 188.5 mm
