vistorx/CatWandConnect/stls/cat_playing_platform_V1/Servo support.stl

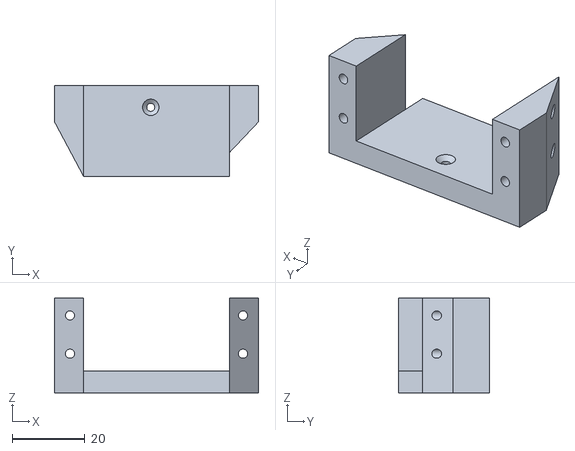
[picture p22: CAD file, 2026-10-08]
stls/cat_playing_platform_V1/Servo support.stl
56.0 x 25.0 x 26.0
