vistorx/CatWandConnect/stls/mk3/catwandconnect-mk3-arm.stl

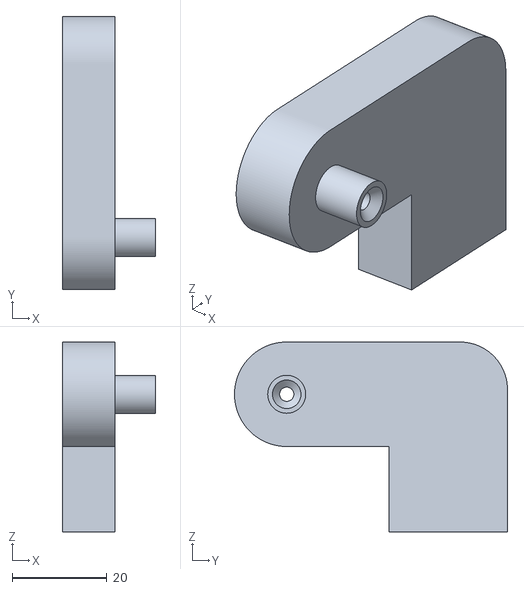
[picture p23: CAD file, 2026-10-17]
stls/mk3/catwandconnect-mk3-arm.stl
19.5 x 57.5 x 40.0
