vistorx/CatWandConnect/(list of files, cad)

Other CAD files:
cads/mk3/catwandconnect-mk3-clamp.step
cads/mk3/catwandconnect-mk3-top_plate.step
stls/mk3/catwandconnect-mk3-rotor_plate.stl
cads/mk3/catwandconnect-mk3-bearing_holder.step
cads/mk3/catwandconnect-mk3-door.step
cads/mk3/catwandconnect-mk3-screw.step
stls/cat_playing_platform_V1/CLAMP - Screw.stl
stls/cat_playing_platform_V1/CLAMP - Screw_pad.stl
stls/mk3/catwandconnect-mk3-screw.stl
