vistorx/CatWandConnect/docs/wiring.fr.md

# Câbler l'électronique

Ce guide câble la carte, les deux servos et l'alimentation USB-C sur la table, et les teste. Compte environ une heure, avec un peu de soudure : quatre soudures, rien de compliqué.

<!-- github-only -->
CatWandConnect tutorial - Wiring (https://youtu.be/qAPqGfsNPbk)
<!-- /github-only -->
<iframe style="width:100%;aspect-ratio:16/9;border:0" src="https://www.youtube-nocookie.com/embed/qAPqGfsNPbk" title="CatWandConnect tutorial - Wiring" allow="accelerometer; clipboard-write; encrypted-media; gyroscope; picture-in-picture; web-share" referrerpolicy="strict-origin-when-cross-origin" allowfullscreen></iframe>

La vidéo montre toutes les étapes de [Monter pas à pas](#monter-pas-à-pas) ([voir sur YouTube](https://youtu.be/qAPqGfsNPbk)).

## Ce qu'il te faut

| Qté | Pièce | Remarques |
|-----|---|---|
| 1 | Carte de développement ESP32, ESP32-S3 ou ESP32-C3 | N'importe quelle carte avec USB, à partir d'environ 3 €. |
| 2 | Servos MG996R (parfois vendus sous le nom SG996R) | Version plus robuste : [DS3218](#servos-plus-robustes--ds3218). |
| 1 | Chargeur USB-C PD, 30 W minimum, 45 W conseillé | Doit proposer le 20 V. Voir [Choisir le chargeur](#choisir-le-chargeur). |
| 1 | Carte de déclenchement USB-C PD (*PD trigger*) | Demande 20 V au chargeur. |
| 1 | Convertisseur abaisseur (*buck*), sortie 5 V, 5 A ou plus | Transforme le 20 V en 5 V. |
| 2 | Connecteurs à levier (type Wago 221), 2 entrées (par ex. 221-412) | Les rails +5 V et GND. |
| 3 | Rallonges de servo, environ 30 cm (3 broches, modèle standard) | Deux pour les servos, une pour la carte. |
| 40 cm | Fil d'environ 0,5 mm² (AWG 20) | 2 × 5 cm et 2 × 15 cm. |

Outils : un fer à souder et un multimètre.

**[Liste complète des pièces →](bom.fr.md)**

<details markdown="1">
<summary>Exemples de composants, servos plus robustes et autres options</summary>

### Exemples de composants

Ce sont les composants du montage de référence. Les annonces changent avec le temps et n'importe quel composant équivalent convient. Les liens sont des exemples, ni sponsorisés ni affiliés.

| Pièce | Exemples d'annonces (AliExpress) | Ce qu'il faut chercher |
|---|---|---|
| Servo MG996R (parfois vendu sous le nom SG996R) | [Exemple](https://fr.aliexpress.com/item/1005012099566939.html) | Taille standard, pignons métalliques, 180°. |
| Servo DS3218 (version plus robuste) | [Exemple](https://fr.aliexpress.com/item/1005010498819386.html) | La version **180°**, pignons métalliques, classe 20 kg·cm. Voir [Servos plus robustes](#servos-plus-robustes--ds3218). |
| Carte de déclenchement USB-C PD | [Exemple 1](https://www.aliexpress.com/item/1005010610660644.html), [exemple 2](https://www.aliexpress.com/item/1005005461879717.html) | Entrée USB-C, PD3.0/PD3.1 (QC3.0 en bonus), sortie au choix de 5 à 48 V, 5 A. |
| Convertisseur abaisseur | [8 A](https://www.aliexpress.com/item/1005009516551580.html), [5 A](https://www.aliexpress.com/item/1005009289437405.html) | Entrée jusqu'à 25 V, sortie au choix ou réglable (3,3/5/9/12 V), réglée sur 5 V. Un 8 A donne de la marge. |

### Servos plus robustes : DS3218

Le DS3218 coûte plus cher que le MG996R, mais il est bien plus solide et a beaucoup plus de couple (classe 20 kg·cm, pignons métalliques). Il a la même taille de servo standard, il devrait donc tenir dans les mêmes supports du Mk3 (pas encore vérifié).

- Prends la version **180°**. Le DS3218 existe aussi en 270°, ce qui fausserait les angles.
- Sa plage d'impulsions est d'environ 500–2500 µs : règle-la dans **Réglages → Matériel → Câblage**, puis relance la calibration. Voir [Plage d'impulsions des servos](#plage-dimpulsions-des-servos).
- Il tire plus de courant quand il force, jusqu'à environ 2,5–3 A chacun. Avec deux DS3218, prends le convertisseur 8 A et un chargeur de 45 W.

### Autres options

- **Condensateur** (470–1000 µF, 10 V ou plus), facultatif : entre les rails +5 V et GND, près des servos, si la carte redémarre ou si les mouvements saccadent.
- **Une simple alimentation 5 V** de 3 A ou plus marche à la place du chargeur, de la carte de déclenchement et du convertisseur : branche-la directement sur les rails +5 V et GND.
- **D'autres rails :** des connecteurs plus grands, un bornier ou une plaque à trous marchent aussi bien que les connecteurs à levier.
- **Des fils Dupont femelles**, si les broches 5V/VIN et GND de ta carte ne sont pas côte à côte (voir l'étape 11).

</details>

## Trois règles

- **Règle et vérifie les tensions avant de brancher quoi que ce soit** (étape 8) : 20 V en sortie de la carte de déclenchement, 5 V en sortie du convertisseur.
- **N'alimente jamais les servos par la carte**, et ne mets jamais le + sur la broche 3,3 V de la carte.
- **Laisse le chargeur débranché**, sauf quand une étape dit le contraire.

## Monter pas à pas

Voici comment est câblé le montage de référence. Un autre montage ? Le [tableau et le schéma de câblage](#câblage) plus bas valent pour tous les montages. Câble-le d'abord sur la table ; il entre dans le robot dans [Assembler le robot](assembly.fr.md).

### 0. Sors les composants

Pose tout sur le plan de travail : les trois rallonges de servo, les deux connecteurs à levier, les fils de 5 cm et de 15 cm, la carte, la carte de déclenchement USB-C PD, le convertisseur abaisseur, l'étain et le fer à souder.

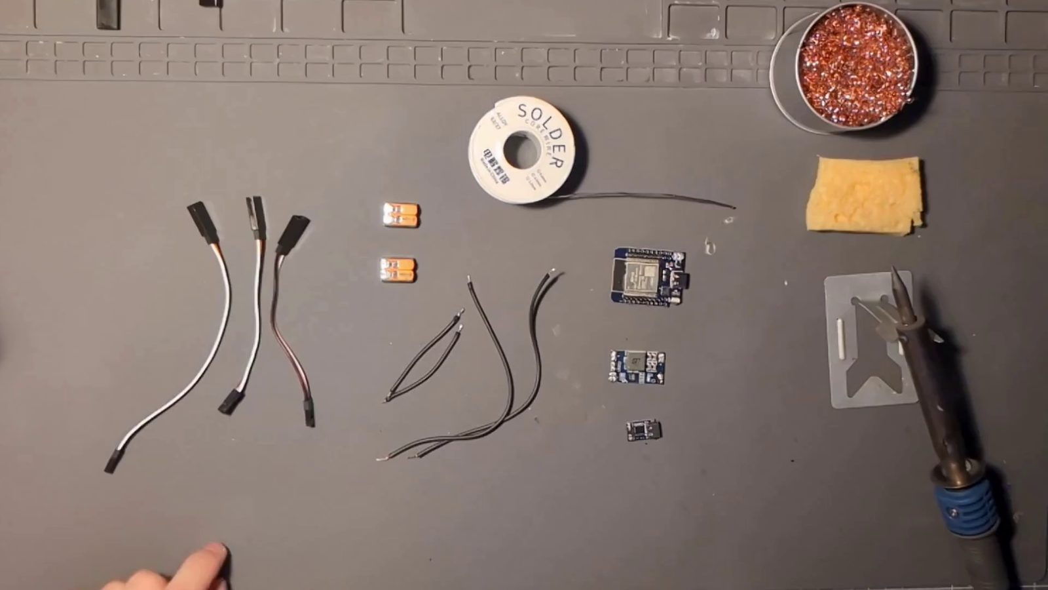
[picture p44: media/photos/wiring-step-00-parts.jpg]
Tous les composants sur le plan de travail : trois rallonges de servo, deux connecteurs à levier, quatre fils noirs, la carte ESP32, le convertisseur abaisseur, la carte de déclenchement, une bobine d'étain et le fer à souder.


### 1. Prépare les rallonges de servo

Chaque rallonge a une petite prise (pour les broches de la carte) et une prise de servo. Ici, le fil de signal est blanc, le + rouge et le − noir (sur d'autres : orange, rouge et marron).

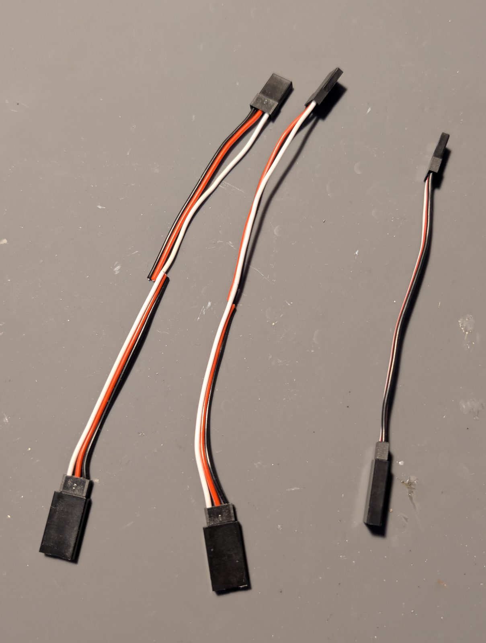
[picture p45: media/photos/wiring-step-01-extensions.jpg]
Trois rallonges de servo côte à côte, chacune avec une petite prise à un bout et la prise du servo à l'autre.


### 2. Le câble d'alimentation de la carte

Coupe la première rallonge et garde la moitié avec la petite prise. Retire son fil de signal, puis dénude le + et le −.

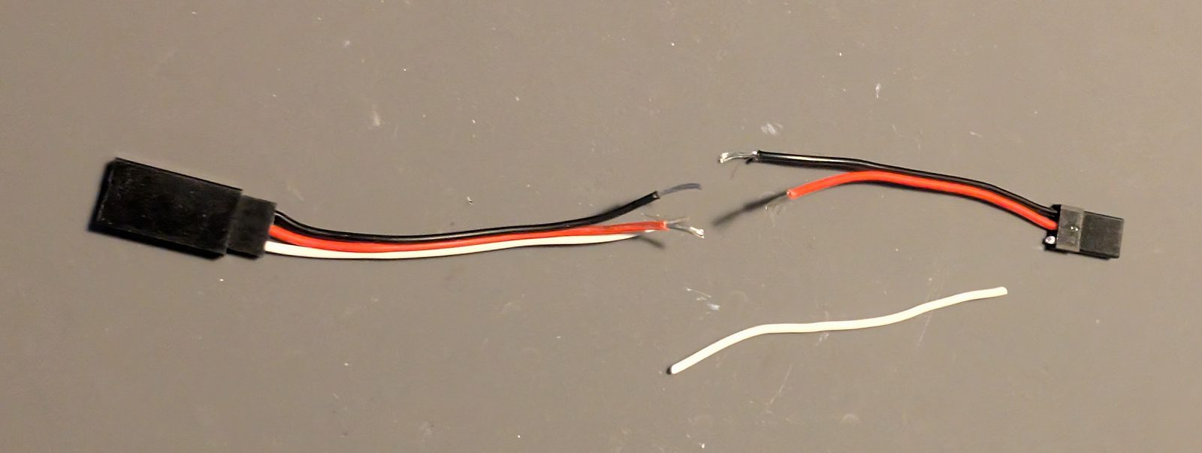
[picture p46: media/photos/wiring-step-02-board-extension.jpg]
À gauche, la moitié avec la prise du servo, qui ne sert pas ; à droite, la moitié avec la petite prise, ses fils rouge et noir dénudés et son fil de signal blanc retiré.


### 3. Les deux câbles des servos

Sur les deux autres rallonges, garde le fil de signal entier. Coupe le + et le − près de la petite prise, garde-les du côté de la prise du servo et dénude-les.

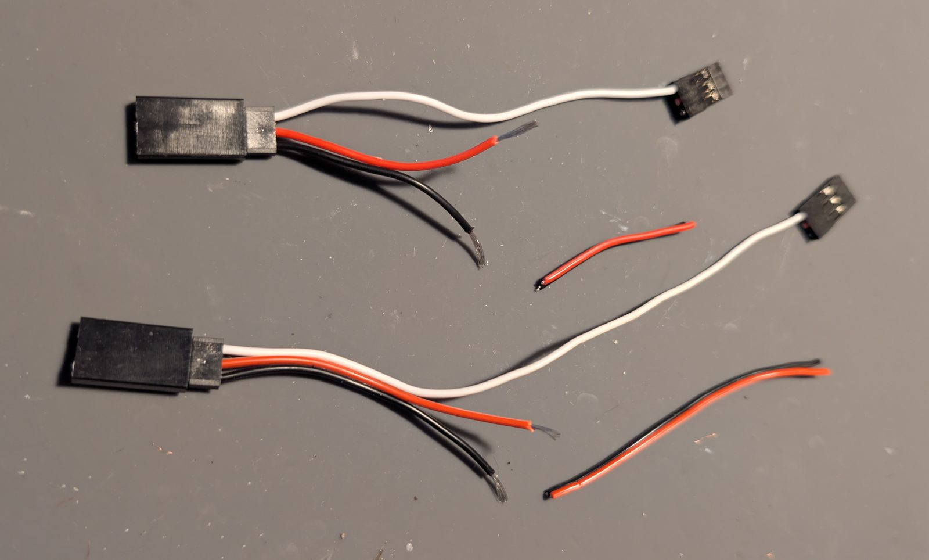
[picture p47: media/photos/wiring-step-03-servo-extensions.jpg]
Deux rallonges de servo : le fil de signal blanc va de la prise du servo à la petite prise ; les fils rouge et noir partent de la prise du servo et s'arrêtent, dénudés ; les bouts rouges et noirs coupés sont posés à côté.


### 4–5. Rassemble les + et les −

Torsade ensemble les trois fils +, puis les trois fils −.

<p>
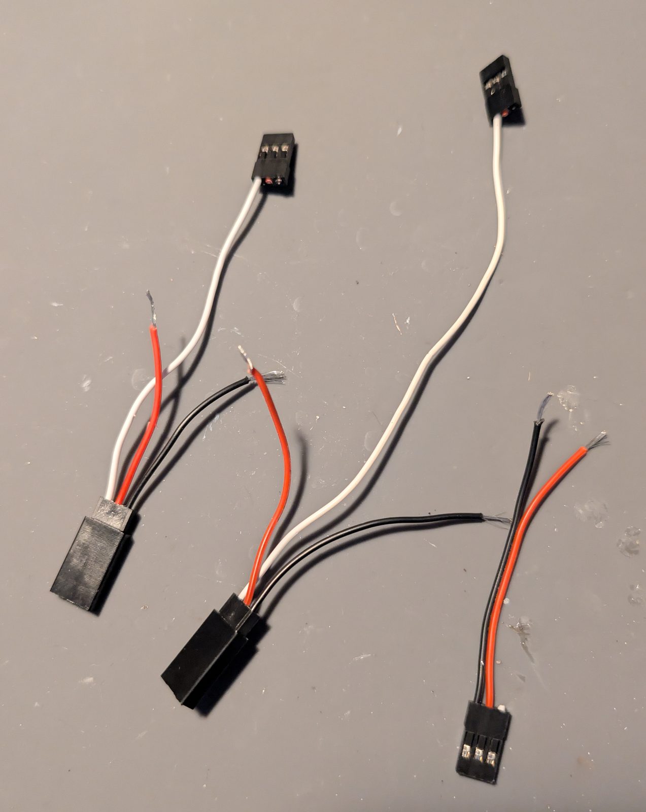
[picture p48: media/photos/wiring-step-04-gather.jpg]
Les trois rallonges préparées : celle de la carte avec seulement le rouge et le noir, et les deux des servos avec leur fil blanc entier et leurs fils rouge et noir dénudés.
  
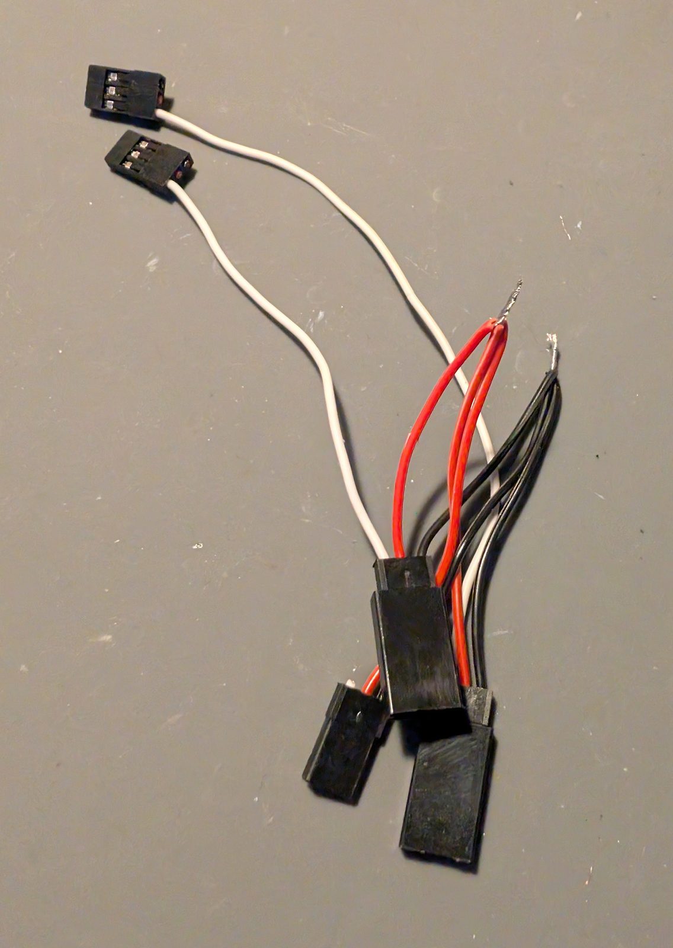
[picture p49: media/photos/wiring-step-05-gathered.jpg]
Les trois rallonges tenues ensemble : les trois fils rouges torsadés en un paquet et les trois noirs en un autre, les deux fils de signal blancs à part.
  
</p>

### 6. Sortie de la carte de déclenchement

Soude les deux fils de 5 cm sur la sortie de la carte de déclenchement, + et −.

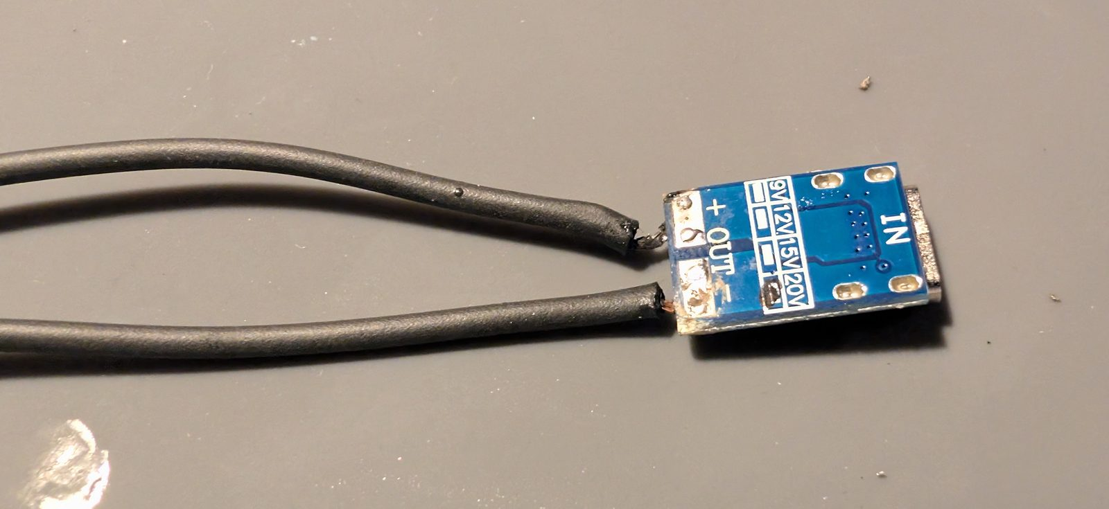
[picture p50: media/photos/wiring-step-06-trigger-board-output.jpg]
La carte de déclenchement avec un fil soudé sur chacune de ses pastilles OUT, + et −.


### 7. Entrée du convertisseur

Soude leur autre bout sur les broches IN du convertisseur : + sur +, − sur −.

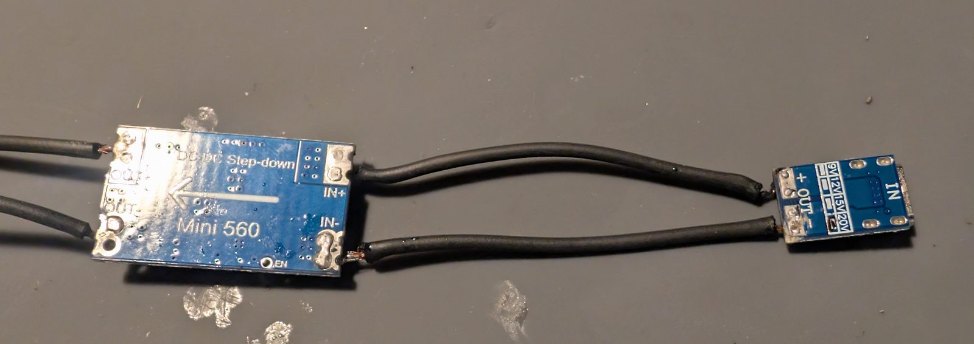
[picture p51: media/photos/wiring-step-07-buck-input.jpg]
La sortie de la carte de déclenchement reliée aux broches IN+ et IN− du convertisseur.


### 8. Sortie du convertisseur, et vérifie les tensions

Soude les deux fils de 15 cm sur les broches OUT du convertisseur, + et −. Ils devront atteindre la cavité technique plus tard.

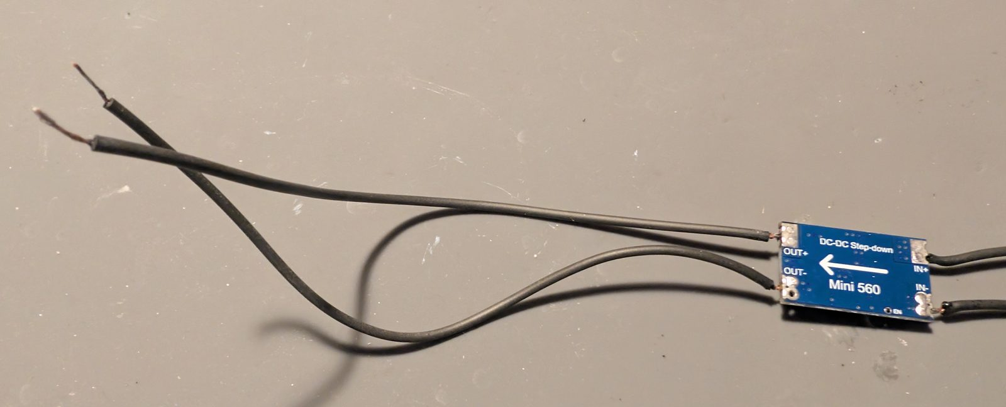
[picture p52: media/photos/wiring-step-08-buck-output.jpg]
Deux fils plus longs soudés sur les broches OUT+ et OUT− du convertisseur.


**Règle et vérifie maintenant les tensions**, sans rien brancher d'autre : branche la carte de déclenchement sur le chargeur, règle-la sur 20 V et vérifie environ 20 V au multimètre ; règle la sortie du convertisseur sur 5 V et vérifie environ 5 V. Débranche ensuite le chargeur. [Comment →](#alimentation)

### 9. Connecteurs à levier

Mets un connecteur à levier au bout de chaque fil de 15 cm : un sur le +, un sur le −.

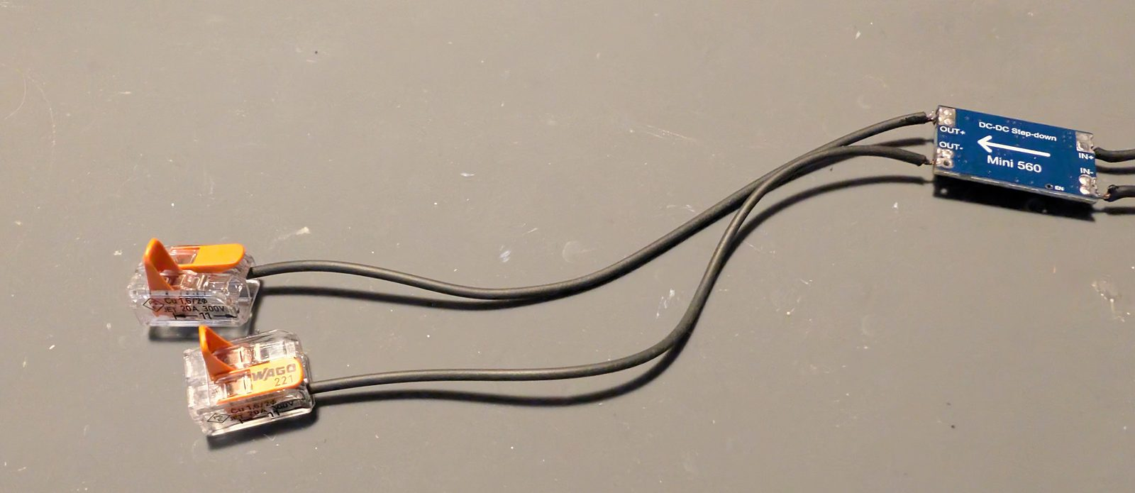
[picture p53: media/photos/wiring-step-09-lever-connectors.jpg]
Un connecteur à levier au bout de chacun des deux fils de sortie du convertisseur.


### 10. Les rails

Mets le paquet de + dans la seconde entrée du connecteur du +, et le paquet de − dans celui du −. Ce sont les rails +5 V et GND.

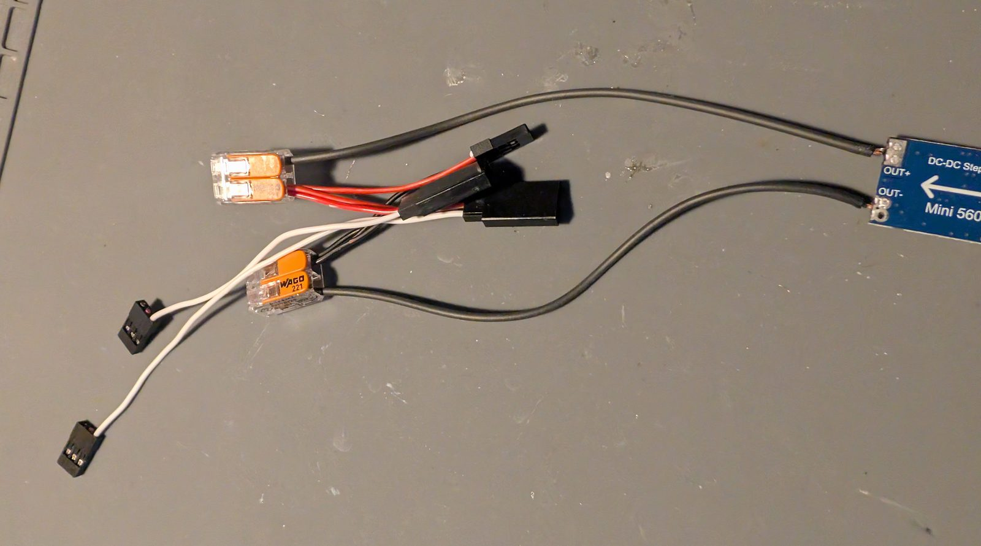
[picture p54: media/photos/wiring-step-10-rails.jpg]
Le paquet rouge dans le connecteur à levier du + et le paquet noir dans celui du − ; les deux prises des servos et les deux fils de signal blancs sortent des rails.


### 11–12. Alimente la carte

Enfiche la prise d'alimentation de la carte sur ses broches **VCC** (5V/VIN) et **GND** : le + sur VCC, le − sur GND. Sur la carte de référence (Mini D1 ESP32), elles sont côte à côte, encadrées en vert.

**Vérifie d'abord le brochage de ta carte.** Broches pas côte à côte ? Utilise plutôt deux fils Dupont femelles.

<p>
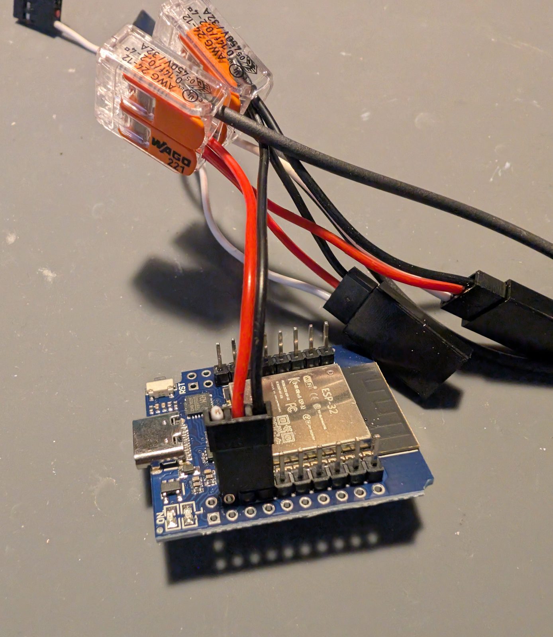
[picture p55: media/photos/wiring-step-11-board-power.jpg]
La petite prise avec les fils rouge et noir enfichée sur deux broches de la carte ESP32.
  
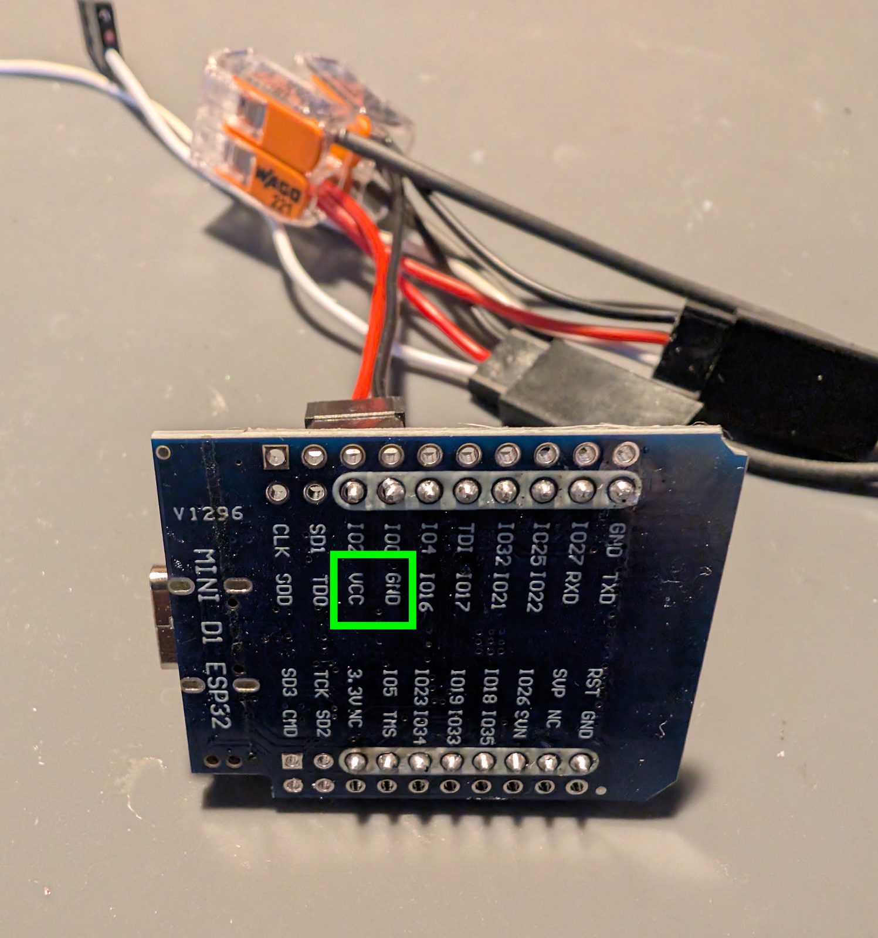
[picture p56: media/photos/wiring-step-12-board-power-pins.jpg]
Le dos de la carte Mini D1 ESP32, avec les broches VCC et GND encadrées en vert.
  
</p>

### 13–14. Fils de signal

Enfiche la petite prise de chaque câble de servo sur **GPIO 18** et **GPIO 19** (S3/C3 : **GPIO 4** et **GPIO 5**). Peu importe lequel va où : tu peux les échanger plus tard dans **Réglages → Matériel → Câblage**.

<p>
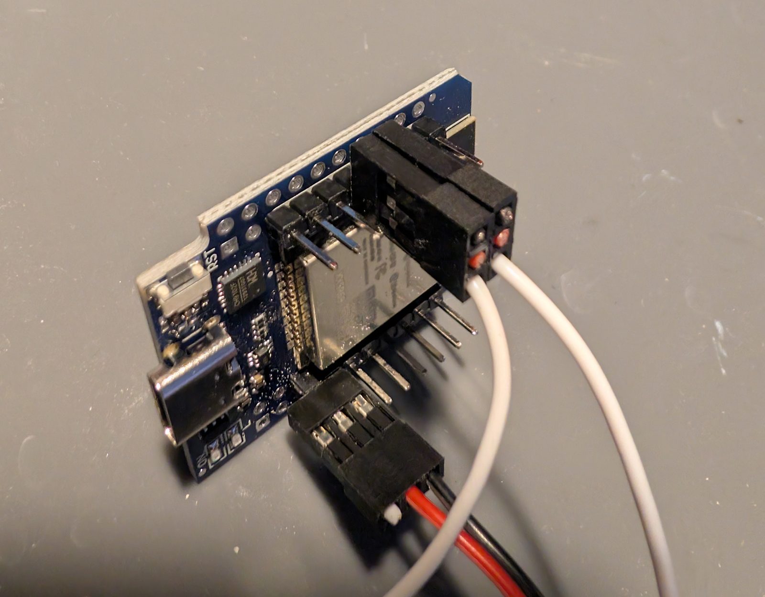
[picture p57: media/photos/wiring-step-13-signal-wires.jpg]
Les deux fils de signal blancs enfichés sur la carte, à côté de la prise d'alimentation.
  
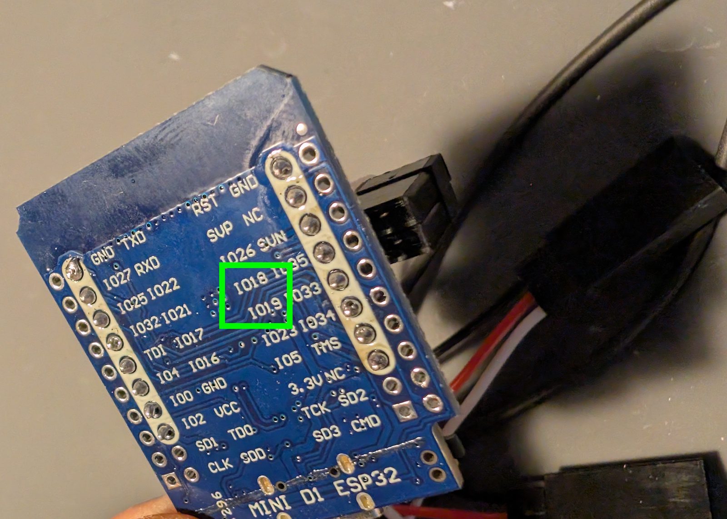
[picture p58: media/photos/wiring-step-14-signal-pins.jpg]
Le dos de la carte, avec les broches IO18 et IO19 encadrées en vert.
  
</p>

### 15. Teste l'alimentation

Branche la carte de déclenchement sur le chargeur : la LED de la carte s'allume. Sinon, débranche tout de suite et vérifie les tensions et chaque + et −.

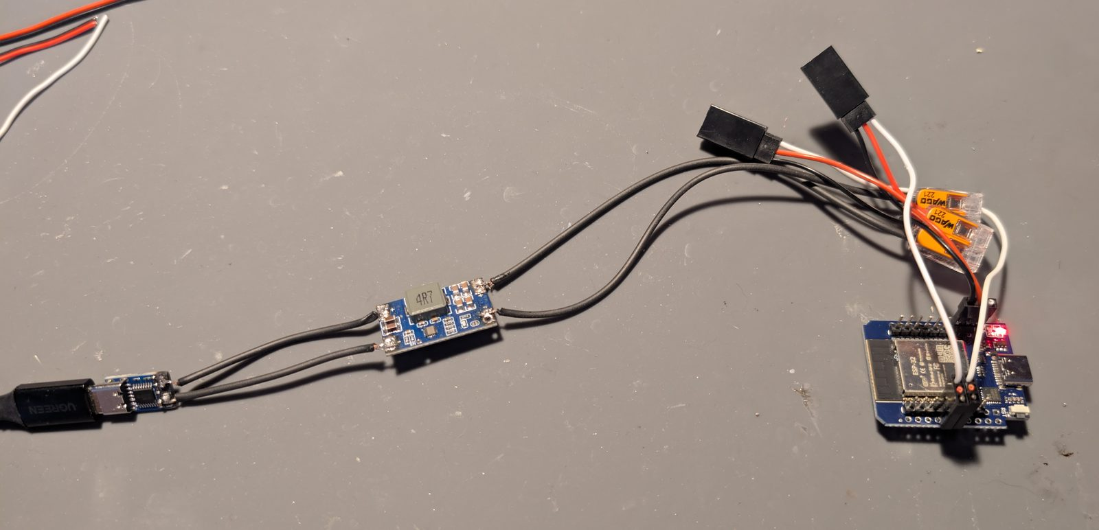
[picture p59: media/photos/wiring-step-15-power-test.jpg]
Toute la chaîne sur la table : le câble USB-C dans la carte de déclenchement, le convertisseur, les connecteurs à levier avec les deux prises des servos, et la carte ESP32 avec sa LED allumée.


L'électronique est prête. Ensuite : [Installer le logiciel](install.fr.md), puis [Assembler le robot](assembly.fr.md).

## Détails, pour d'autres montages et pour plus tard

Tu n'as pas besoin de cette partie pour suivre les étapes ci-dessus.

<details markdown="1">
<summary>Câblage pour tous les montages : tableau et schéma</summary>

## Câblage

La sortie 5 V du convertisseur abaisseur alimente les deux servos et la carte. Chaque MG996R a trois fils : **orange** (signal), **rouge** (+5 V) et **marron** (masse).

| Fil | À brancher sur |
|-----|---|
| Rouge des servos | +5 V |
| Marron des servos | GND |
| Orange du servo horizontal | GPIO 18 (S3/C3 : GPIO 4) |
| Orange du servo vertical | GPIO 19 (S3/C3 : GPIO 5) |
| Broche 5V / VIN de la carte | +5 V |
| Broche GND de la carte | GND |

Utilise un petit bornier, un connecteur type Wago ou une plaque à trous comme « rails » +5 V et GND sur lesquels tout se branche.

![Câblage : un chargeur USB-C (30–45 W) alimente une carte de déclenchement PD réglée sur 20 V, qui alimente un convertisseur abaisseur réglé sur 5 V ; le convertisseur alimente un rail +5 V et un rail GND ; les fils rouge et marron des deux servos et les broches 5V et GND de la carte se branchent sur les rails ; le GPIO 18 va au fil orange du servo horizontal et le GPIO 19 à celui du servo vertical ; un condensateur est placé entre les rails, près des servos.](images/wiring.svg)

- La carte prend son alimentation sur sa broche **5V/VIN**. Le firmware pilote les servos avec des impulsions PWM à 50 Hz ; la carte envoie seulement les signaux.
- Ne branche l'USB de la carte sur un ordinateur que pour flasher ou lire les logs. La plupart des cartes ont une diode qui empêche le 5 V externe de remonter vers l'ordinateur, mais pas toutes : si tu n'es pas sûr de la tienne, débranche d'abord le chargeur USB-C.

</details>

<details markdown="1">
<summary>Alimentation : la chaîne USB-C et le chargeur</summary>

## Alimentation

Le robot fonctionne avec un chargeur USB-C, à travers deux petites cartes :

1. **Chargeur USB-C** → **carte de déclenchement PD**, par un câble USB-C. La carte de déclenchement demande 20 V au chargeur.
2. **Carte de déclenchement PD** → **convertisseur abaisseur** : le 20 V entre dans le convertisseur.
3. **Convertisseur abaisseur** → **rails +5 V et GND** : sa sortie 5 V alimente les deux servos et la carte.

Règle les deux cartes **avant** de brancher les servos ou la carte :

1. Règle la carte de déclenchement sur **20 V** (avec son pont de soudure, son cavalier ou son bouton, comme l'explique son annonce), branche-la au chargeur et vérifie sa sortie au multimètre : environ 20 V.
2. Branche le convertisseur, règle sa sortie sur **5 V** et vérifie-la au multimètre : environ 5 V.
3. Seulement ensuite, branche la sortie du convertisseur sur les rails +5 V et GND.

**Ne choisis jamais une tension de déclenchement supérieure à l'entrée maximale du convertisseur.** Les convertisseurs donnés en exemple acceptent jusqu'à 25 V : 20 V est le bon choix, et 28 V ou plus les détruirait.

### Choisir le chargeur

Prends un bon chargeur USB-C PD qui propose le 20 V : **30 W minimum, 45 W c'est beaucoup mieux**. Deux MG996R peuvent tirer chacun plus de 1 A quand ils forcent, et les deux cartes perdent un peu de puissance en la convertissant. 30 W suffit ; 45 W laisse de la marge pour que le chargeur ne coupe pas quand les deux servos démarrent ensemble.

</details>

<details markdown="1">
<summary>Toutes les règles, et que faire si la carte redémarre</summary>

## Règles

- **Masse commune.** Le GND de la carte doit être relié au − de la sortie du convertisseur, sinon les servos tremblent ou ignorent le signal.
- **N'alimente jamais les servos par la carte.** Ni par sa broche 3,3 V, ni par sa broche 5 V quand elle est alimentée par l'USB. Un MG996R peut tirer plus de 1 A quand il force.
- **Dimensionne l'alimentation.** Prévois 5 A ou plus en 5 V pour deux MG996R : un convertisseur de 5 A ou plus, un chargeur de 30 W ou plus (ou une simple alimentation 5 V de 3 A ou plus). Une alimentation trop faible fait redémarrer la carte quand les deux servos démarrent ensemble : on voit souvent le robot redémarrer quand la baguette bouge.
- **Fils d'alimentation épais.** Garde les fils 5 V et de masse vers les servos courts et assez épais.
- **Condensateur.** Si la carte redémarre ou si les mouvements saccadent, ajoute un condensateur (470–1000 µF, 10 V ou plus) entre les rails +5 V et GND, près des servos.

</details>

<details markdown="1">
<summary>Cartes, broches par défaut et plage d'impulsions des servos</summary>

## Cartes compatibles

N'importe quelle carte de développement ESP32, ESP32-S3 ou ESP32-C3. Les cartes ESP8266 ne sont pas compatibles ([ADR 0008](adr/0008-no-esp8266-support.md), en anglais).

## Broches par défaut

| Puce | Servo horizontal | Servo vertical |
|---|---|---|
| ESP32 | GPIO 18 | GPIO 19 |
| ESP32-S3 | GPIO 4 | GPIO 5 |
| ESP32-C3 | GPIO 4 | GPIO 5 |

Sur les S3 et C3, les GPIO 18 et 19 servent à l'USB, d'où des broches par défaut différentes. Pour câbler autrement, choisis les broches dans **Réglages → Matériel → Câblage** ; le robot redémarre pour les appliquer. La liste ne propose que les broches sans danger sur ta puce.

## Plage d'impulsions des servos

Les valeurs par défaut viennent de la preuve de concept : 400–2200 µs pour le servo horizontal et 600–2400 µs pour le vertical, pour 0° à 180°. Si tes servos ne vont pas au bout de leur course, ou grésillent en butée, ajuste la plage d'impulsions dans **Réglages → Matériel → Câblage**. La même section inverse un axe dont le sens est à l'envers. Les deux changements effacent la calibration : relance-la ensuite.

</details>
