vistorx/CatWandConnect/firmware/test/test_robot_core/test_main.cpp

#include <robot_core/robot.h>
#include <unity.h>

#include "../fakes.h"

using namespace cwc;
using namespace cwc::test;

namespace {

struct Rig {
  FakeMotorDriver motors;
  FakeClock clock;
  FakeStorage storage;
  FakeRandom random;
  Robot robot{motors, clock, storage, random};

  // Powers up and lets the robot settle at Stow.
  Rig() {
    robot.begin();
    run(10);
  }

  // Runs the control loop for `ms` milliseconds in 10 ms ticks.
  void run(uint32_t ms) {
    for (uint32_t t = 0; t < ms; t += 10) {
      clock.advance(10);
      robot.tick();
    }
  }

  // Holds the joystick for `ms`, refreshing it every 100 ms like the interface.
  void hold(float horizontal, float vertical, uint32_t ms) {
    for (uint32_t t = 0; t < ms; t += 100) {
      robot.manualMove(horizontal, vertical);
      run(100);
    }
  }
};

}  // namespace

void setUp() {}
void tearDown() {}

void test_power_up_rests_at_stow_with_servos_released() {
  Rig rig;

  TEST_ASSERT_EQUAL(2, rig.motors.moves.size());
  TEST_ASSERT_EQUAL(2, rig.motors.releases.size());
  TEST_ASSERT_TRUE(rig.robot.activity() == Activity::Idle);
  TEST_ASSERT_EQUAL_FLOAT(kDefaultStow, rig.robot.position(Axis::Horizontal));
  TEST_ASSERT_EQUAL_FLOAT(kDefaultStow, rig.robot.position(Axis::Vertical));
}

void test_idle_robot_does_not_move() {
  Rig rig;
  rig.motors.moves.clear();

  rig.run(1000);

  TEST_ASSERT_EQUAL(0, rig.motors.moves.size());
}

void test_joystick_moves_the_axes() {
  Rig rig;

  rig.hold(1, -1, 300);

  TEST_ASSERT_TRUE(rig.robot.activity() == Activity::Manual);
  TEST_ASSERT_TRUE(rig.robot.position(Axis::Horizontal) > kDefaultStow);
  TEST_ASSERT_TRUE(rig.robot.position(Axis::Vertical) < kDefaultStow);
}

void test_manual_control_never_leaves_travel_limits() {
  Rig rig;

  rig.hold(1, -1, 3000);
  rig.hold(-1, 1, 3000);

  for (const auto& move : rig.motors.moves) {
    TravelLimits limits = rig.robot.travelLimits(move.axis);
    TEST_ASSERT_TRUE(move.degrees >= limits.min);
    TEST_ASSERT_TRUE(move.degrees <= limits.max);
  }
  TEST_ASSERT_FLOAT_WITHIN(0.5f, kDefaultTravel.min, rig.robot.position(Axis::Horizontal));
  TEST_ASSERT_FLOAT_WITHIN(0.5f, kDefaultTravel.max, rig.robot.position(Axis::Vertical));
}

void test_out_of_range_deflection_is_capped() {
  Rig full;
  Rig huge;

  full.hold(1, 0, 200);
  huge.hold(50, 0, 200);

  TEST_ASSERT_EQUAL_FLOAT(full.robot.position(Axis::Horizontal), huge.robot.position(Axis::Horizontal));
}

void test_release_stops_the_wand() {
  Rig rig;
  rig.hold(1, 0, 200);

  rig.robot.manualStop();
  rig.run(500);
  float stopped = rig.robot.position(Axis::Horizontal);
  rig.run(1000);

  TEST_ASSERT_EQUAL_FLOAT(stopped, rig.robot.position(Axis::Horizontal));
  TEST_ASSERT_TRUE(rig.robot.activity() == Activity::Idle);
}

void test_silent_controller_stops_the_wand() {
  Rig rig;
  rig.robot.manualMove(0.3f, 0);  // slow enough not to reach the limit before the timeout

  rig.run(Robot::kManualTimeoutMs + 500);
  float stopped = rig.robot.position(Axis::Horizontal);
  rig.run(2000);

  TEST_ASSERT_EQUAL_FLOAT(stopped, rig.robot.position(Axis::Horizontal));
  TEST_ASSERT_TRUE(stopped < kDefaultTravel.max);
  TEST_ASSERT_TRUE(rig.robot.activity() == Activity::Idle);
}

void test_stalled_loop_does_not_leap() {
  Rig rig;
  rig.robot.manualMove(1, 0);

  rig.clock.advance(5000);
  rig.robot.tick();

  // At most one capped step of acceleration from rest.
  TEST_ASSERT_TRUE(rig.robot.position(Axis::Horizontal) - kDefaultStow < 5);
}

void test_manual_speed_follows_settings() {
  Rig rig;
  RobotSettings s = rig.robot.settings();
  s.axis(Axis::Horizontal).maxSpeed = 20;
  s.axis(Axis::Horizontal).minSpeed = 2;
  s.playSpeed = 0.5f;
  TEST_ASSERT_TRUE(rig.robot.applySettings(s).ok());

  rig.hold(1, 0, 2000);

  // 10 °/s for 2 s, minus the time spent accelerating.
  float travelled = rig.robot.position(Axis::Horizontal) - kDefaultStow;
  TEST_ASSERT_TRUE(travelled > 18);
  TEST_ASSERT_TRUE(travelled <= 20.01f);
}

// Runs the joystick fully right for 2 s and returns the distance travelled.
float travelAtSlider(float playSpeed) {
  Rig rig;
  RobotSettings s = rig.robot.settings();
  s.axis(Axis::Horizontal).travel = {0, 180};
  s.axis(Axis::Horizontal).maxSpeed = 40;
  s.axis(Axis::Horizontal).minSpeed = 4;
  s.axis(Axis::Horizontal).maxAccel = kMaxAccel;
  s.calibrated = true;
  s.playSpeed = playSpeed;
  TEST_ASSERT_TRUE(rig.robot.applySettings(s).ok());
  rig.hold(1, 0, 2000);
  return rig.robot.position(Axis::Horizontal) - kDefaultStow;
}

void test_speed_slider_runs_from_minimum_to_maximum_speed() {
  // Slider at 10 %: the minimum speed, 4 °/s for 2 s.
  float slowest = travelAtSlider(kMinPlaySpeed);
  TEST_ASSERT_FLOAT_WITHIN(0.5f, 8, slowest);
  // Slider at 100 %: the maximum speed, 40 °/s for 2 s.
  TEST_ASSERT_FLOAT_WITHIN(1.0f, 80, travelAtSlider(1));
  // Halfway along the slider (55 %): halfway between them, 22 °/s.
  TEST_ASSERT_FLOAT_WITHIN(1.0f, 44, travelAtSlider(0.55f));
}

void test_invalid_settings_are_rejected_whole() {
  Rig rig;
  RobotSettings s = rig.robot.settings();
  s.axis(Axis::Horizontal).maxSpeed = 30;  // valid
  s.axis(Axis::Vertical).stow = 200;       // invalid

  SettingsCheck check = rig.robot.applySettings(s);

  TEST_ASSERT_TRUE(check.error == SettingsError::StowOutOfTravel);
  TEST_ASSERT_TRUE(check.axis == Axis::Vertical);
  TEST_ASSERT_EQUAL_FLOAT(defaultSettings().axis(Axis::Horizontal).maxSpeed,
                          rig.robot.settings().axis(Axis::Horizontal).maxSpeed);
  TEST_ASSERT_EQUAL(0, rig.storage.blobs.count("robot"));
}

void test_settings_are_restored_at_power_up() {
  FakeMotorDriver motors;
  FakeClock clock;
  FakeStorage storage;
  RobotSettings s = defaultSettings();
  s.axis(Axis::Vertical).maxAccel = 100;
  saveSettings(storage, s);

  FakeRandom random;
  Robot robot(motors, clock, storage, random);
  robot.begin();

  TEST_ASSERT_EQUAL_FLOAT(100, robot.settings().axis(Axis::Vertical).maxAccel);
}

void test_default_travel_applies_until_calibrated() {
  Rig rig;
  RobotSettings s = rig.robot.settings();
  s.axis(Axis::Horizontal).travel = {10, 170};
  rig.robot.applySettings(s);
  TEST_ASSERT_EQUAL_FLOAT(kDefaultTravel.max, rig.robot.travelLimits(Axis::Horizontal).max);

  s.calibrated = true;
  rig.robot.applySettings(s);
  TEST_ASSERT_EQUAL_FLOAT(170, rig.robot.travelLimits(Axis::Horizontal).max);
}

void test_stow_returns_and_releases_servos() {
  Rig rig;
  rig.hold(1, 1, 500);
  rig.motors.releases.clear();
  TEST_ASSERT_TRUE(rig.robot.held(Axis::Horizontal));

  rig.robot.stow();
  rig.run(3000);

  TEST_ASSERT_EQUAL_FLOAT(kDefaultStow, rig.robot.position(Axis::Horizontal));
  TEST_ASSERT_EQUAL_FLOAT(kDefaultStow, rig.robot.position(Axis::Vertical));
  TEST_ASSERT_EQUAL(2, rig.motors.releases.size());
  TEST_ASSERT_FALSE(rig.robot.held(Axis::Horizontal));
  TEST_ASSERT_TRUE(rig.robot.activity() == Activity::Idle);
}

void test_servos_release_only_once_at_stow() {
  Rig rig;
  rig.hold(1, 0, 500);
  rig.motors.releases.clear();

  rig.robot.manualStop();
  rig.run(2000);

  TEST_ASSERT_EQUAL(0, rig.motors.releases.size());
  TEST_ASSERT_TRUE(rig.robot.held(Axis::Horizontal));
}

void test_stow_cancels_manual_control_without_resume() {
  Rig rig;
  rig.hold(1, 0, 300);

  rig.robot.stow();
  rig.run(3000);

  TEST_ASSERT_EQUAL_FLOAT(kDefaultStow, rig.robot.position(Axis::Horizontal));
  TEST_ASSERT_TRUE(rig.robot.activity() == Activity::Idle);
}

void test_manual_control_cannot_interrupt_stow() {
  Rig rig;
  rig.hold(1, 0, 500);

  rig.robot.stow();
  rig.hold(-1, -1, 300);  // someone keeps pushing the joystick
  rig.run(3000);

  TEST_ASSERT_EQUAL_FLOAT(kDefaultStow, rig.robot.position(Axis::Horizontal));
  TEST_ASSERT_EQUAL_FLOAT(kDefaultStow, rig.robot.position(Axis::Vertical));
}

void test_manual_control_after_stow_holds_servos_again() {
  Rig rig;
  rig.motors.moves.clear();

  rig.hold(0, 1, 200);

  TEST_ASSERT_TRUE(rig.motors.moves.size() > 0);
  TEST_ASSERT_TRUE(rig.robot.held(Axis::Vertical));
}

void test_stow_stays_within_travel_limits() {
  Rig rig;
  rig.hold(-1, 1, 3000);

  rig.robot.stow();
  rig.run(3000);

  for (const auto& move : rig.motors.moves) {
    TravelLimits limits = rig.robot.travelLimits(move.axis);
    TEST_ASSERT_TRUE(move.degrees >= limits.min && move.degrees <= limits.max);
  }
}

void test_stow_uses_the_configured_position() {
  Rig rig;
  RobotSettings s = rig.robot.settings();
  s.axis(Axis::Vertical).stow = 70;
  TEST_ASSERT_TRUE(rig.robot.applySettings(s).ok());

  rig.robot.stow();
  rig.run(3000);

  TEST_ASSERT_EQUAL_FLOAT(70, rig.robot.position(Axis::Vertical));
}

void test_goto_moves_to_the_position_and_stops() {
  Rig rig;

  rig.robot.manualGoto(Axis::Horizontal, 110);
  rig.run(5000);

  TEST_ASSERT_EQUAL_FLOAT(110, rig.robot.position(Axis::Horizontal));
  TEST_ASSERT_EQUAL_FLOAT(kDefaultStow, rig.robot.position(Axis::Vertical));
  TEST_ASSERT_TRUE(rig.robot.activity() == Activity::Idle);
}

void test_goto_is_clamped_into_travel_limits() {
  Rig rig;

  rig.robot.manualGoto(Axis::Vertical, 10);
  rig.run(5000);

  TEST_ASSERT_EQUAL_FLOAT(kDefaultTravel.min, rig.robot.position(Axis::Vertical));
}

void test_goto_respects_the_manual_control_speed() {
  Rig rig;
  float limit = defaultSettings().axis(Axis::Horizontal).maxSpeed * defaultSettings().playSpeed;
  rig.robot.manualGoto(Axis::Horizontal, 120);

  float previous = rig.robot.position(Axis::Horizontal);
  for (int i = 0; i < 300; ++i) {
    rig.run(10);
    float now = rig.robot.position(Axis::Horizontal);
    TEST_ASSERT_TRUE(now - previous <= limit * 0.01f + 0.001f);
    previous = now;
  }
}

void test_goto_does_not_time_out_like_the_joystick() {
  Rig rig;
  RobotSettings s = rig.robot.settings();
  s.axis(Axis::Horizontal).maxSpeed = 10;  // 6 °/s at the default play speed: a 3 s trip
  s.axis(Axis::Horizontal).minSpeed = 1;
  rig.robot.applySettings(s);

  rig.robot.manualGoto(Axis::Horizontal, 108);
  rig.run(5000);

  TEST_ASSERT_EQUAL_FLOAT(108, rig.robot.position(Axis::Horizontal));
}

void test_stow_and_joystick_cancel_goto() {
  Rig rig;
  rig.robot.manualGoto(Axis::Horizontal, 120);
  rig.run(200);
  rig.robot.stow();
  rig.run(5000);
  TEST_ASSERT_EQUAL_FLOAT(kDefaultStow, rig.robot.position(Axis::Horizontal));

  rig.robot.manualGoto(Axis::Horizontal, 120);
  rig.run(200);
  rig.robot.manualStop();
  rig.run(3000);
  TEST_ASSERT_TRUE(rig.robot.position(Axis::Horizontal) < 120);
}

void test_goto_is_ignored_while_stowing() {
  Rig rig;
  rig.hold(1, 0, 500);
  rig.robot.stow();

  rig.robot.manualGoto(Axis::Horizontal, 115);
  rig.run(5000);

  TEST_ASSERT_EQUAL_FLOAT(kDefaultStow, rig.robot.position(Axis::Horizontal));
}

int main() {
  UNITY_BEGIN();
  RUN_TEST(test_power_up_rests_at_stow_with_servos_released);
  RUN_TEST(test_idle_robot_does_not_move);
  RUN_TEST(test_joystick_moves_the_axes);
  RUN_TEST(test_manual_control_never_leaves_travel_limits);
  RUN_TEST(test_out_of_range_deflection_is_capped);
  RUN_TEST(test_release_stops_the_wand);
  RUN_TEST(test_silent_controller_stops_the_wand);
  RUN_TEST(test_stalled_loop_does_not_leap);
  RUN_TEST(test_manual_speed_follows_settings);
  RUN_TEST(test_speed_slider_runs_from_minimum_to_maximum_speed);
  RUN_TEST(test_invalid_settings_are_rejected_whole);
  RUN_TEST(test_settings_are_restored_at_power_up);
  RUN_TEST(test_default_travel_applies_until_calibrated);
  RUN_TEST(test_stow_returns_and_releases_servos);
  RUN_TEST(test_servos_release_only_once_at_stow);
  RUN_TEST(test_stow_cancels_manual_control_without_resume);
  RUN_TEST(test_manual_control_cannot_interrupt_stow);
  RUN_TEST(test_manual_control_after_stow_holds_servos_again);
  RUN_TEST(test_stow_stays_within_travel_limits);
  RUN_TEST(test_stow_uses_the_configured_position);
  RUN_TEST(test_goto_moves_to_the_position_and_stops);
  RUN_TEST(test_goto_is_clamped_into_travel_limits);
  RUN_TEST(test_goto_respects_the_manual_control_speed);
  RUN_TEST(test_goto_does_not_time_out_like_the_joystick);
  RUN_TEST(test_stow_and_joystick_cancel_goto);
  RUN_TEST(test_goto_is_ignored_while_stowing);
  return UNITY_END();
}
