vistorx/CatWandConnect/(commit log)

2026-10-08 Initial snapshot of CatWandConnect
    Move ESPHome credentials out of the config into !secret references,
    add secrets.yaml.example and ignore secrets.yaml and paid V2 assets.
    [CLAMP - Clamp.stl, CLAMP - Pad.stl, CLAMP - Screw.stl, CLAMP - Screw_pad.stl, Part Studio 1 - Part 2.stl, Part Studio 1 - Part 3.stl, Servo support.stl, Stick support.stl]
2026-10-08 Track cat_playing_platform_V2 assets
    [cat_playing_platform_v2 - arm.stl, cat_playing_platform_v2 - bearing.stl, cat_playing_platform_v2 - clamp.stl, cat_playing_platform_v2 - rotor_plate.stl, cat_playing_platform_v2 - screw.stl, cat_playing_platform_v2 - top_plate.stl, cat_playing_platform_v2.3mf]
2026-10-08 Frame the project: glossary, ADRs, drop ESPHome PoC
    Add CONTEXT.md glossary and ADRs 0001-0007 from the design session
    (open licences, standalone dedicated firmware, MQTT for Home Assistant,
    plain web interface). Remove the ESPHome proof of concept (kept in
    8a373a5), rename mechanisms to Mk1 (archived) and Mk2, add FUNDING.yml.
    [CLAMP - Clamp.stl, CLAMP - Pad.stl, CLAMP - Screw.stl, CLAMP - Screw_pad.stl, Part Studio 1 - Part 2.stl, Part Studio 1 - Part 3.stl, Servo support.stl, Stick support.stl]
2026-10-09 Firmware skeleton and CI (#16)
    * Add firmware skeleton and CI (#2)
    PlatformIO project building Arduino-ESP32 for ESP32, ESP32-S3 and
    ESP32-C3, an empty Robot core (pure C++17) injected with MotorDriver,
    Clock and Storage ports, a native Unity smoke test with fakes, and a
    GitHub Actions workflow running the tests and the three builds.
    Closes #2
    * Run CI once per PR, on push to main only
    ---------
2026-10-09 Add Manual control: joystick, WebSocket API, servo driver (#5) (#18)
    The Device interface (plain HTML/CSS/JS, embedded gzip-compressed at
    build time, text in lang/en.json) shows a joystick and live positions.
    Joystick deflections travel over the /ws WebSocket into the Robot core,
    which moves each Axis with speed and acceleration limits, brakes before
    the default Travel limits, and stops when the joystick is released, the
    client goes silent for 500 ms or disconnects. A LEDC PWM driver applies
    positions to the servos with the PoC pulse ranges and pins.
    Closes #5
2026-10-09 Add speed, acceleration and persistent settings (#6) (#19)
    The Robot core gains versioned RobotSettings (Travel limits, Stow,
    maximum speed and acceleration per Axis, play speed, calibrated flag),
    validated as a whole and restored at boot; unknown versions, corrupted
    or invalid records fall back to defaults. Manual control now moves at
    playSpeed x maxSpeed within each axis's acceleration.
    The Device API exposes GET/PUT /api/settings, with every robot access
    under a lock shared with the main loop. The interface gets a speed
    slider and a Settings page. tools/dev_server.mjs serves the interface
    with a simulated robot for work without hardware.
    Closes #6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
2026-10-09 Add Stow, command priority, hold and release (#7) (#20)
    The Robot core gains a Stowing activity: Stow stops Manual control,
    moves both axes to the Stow position within the Travel limits and
    releases the servos there. Manual control is ignored until Stow
    completes and nothing resumes afterwards. Servos are held while
    driven and released only at Stow; power-up now ends released at Stow.
    The API adds the stow WebSocket message, POST /api/stow and the held
    flag; the main screen gets a large Stow button pinned to the bottom.
    Closes #7
2026-10-11 Add gentle power-up from the remembered resting position (#9) (#21)
    The Robot core remembers where the wand last came to rest, written only
    when it becomes idle and the position changed. At power-up it commands
    that position, clamped into the Travel limits, so the servos don't
    jump, then Stows at kMinSpeed. Without a valid remembered position it
    goes straight to Stow.
    Closes #9
2026-10-11 Record that ESP8266 is not supported (ADR 0008) (#22)
    Too little RAM and flash for the interface, WebSocket, MQTT and OTA,
    software-only servo PWM, no Bluetooth, and a separate platform layer to
    maintain, for no cost saving over an ESP32-C3. Getting-started and
    AGENTS.md now say so; the getting-started status is brought up to date.
2026-10-11 Rewrite README and hardware docs, add licences and trademark policy (#3) (#23)
    - README: what CatWandConnect is, feature status, Mk2 printed parts and
    BOM, supported boards (no ESP8266), first start, docs, contributing,
    GitHub Sponsors, licensing.
    - LICENSES/ with the official GPL-3.0, CERN-OHL-S-2.0 and CC BY-SA 4.0
    texts, LICENSE.md mapping them to firmware, hardware and docs.
    - TRADEMARK.md reserving the name for official kits and explaining
    "compatible with CatWandConnect".
    - Electronics, assembly and troubleshooting rewritten for the Mk2 and
    the dedicated firmware.
    Closes #3
2026-10-11 Add the Calibration wizard (#8) (#24)
    The Robot core gains a Calibration state machine: per-axis minimum and
    maximum, Stow position, an automatic sweep of the new envelope, then
    confirmation. Nudges move only the step's axis, slowly, anywhere in the
    servo range; marks are validated (max above min, Stow inside); nothing
    is saved until confirm, and cancel, Stow or Manual control keep the
    previous settings. Movement stays within the defaults until done.
    The API adds GET/POST /api/calibration and the calibration step in the
    state message. The interface gets the wizard, a "not calibrated" banner
    on the main screen and numeric Travel limits and Stow in Settings.
    Closes #8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
2026-10-11 Add hardware configuration: pins, direction, pulse range (#10) (#25)
    A pure, tested HardwareConfig holds GPIO, direction and pulse range per
    Axis, with per-chip pin rules (no flash, PSRAM, USB, console, strapping
    or input-only pins, no duplicates) and a chip-tagged stored record.
    Changing direction or pulse range forgets Calibration, since the limits
    would no longer match. The servo driver applies the config at boot;
    GET/PUT /api/hardware validate, save and restart the board. Settings
    gains a Wiring section.
    Closes #10
    [device_api.cpp, device_api.h, main.cpp, servo_driver.cpp, servo_driver.h, test_main.cpp]
2026-10-11 Add device naming, Info page, French and home-screen shortcut (#11) (#26)
    A pure, tested identity library turns the owner's name into a hostname
    (lowercase ASCII, accents removed) and a hotspot SSID that fits 32
    bytes. The name drives mDNS, DHCP, the hotspot and Improv; renaming
    restarts the robot. GET /api/info feeds a new Info page.
    The interface ships a complete French translation, a per-browser
    language choice, a web manifest and icons. tools/check_lang.mjs keeps
    language files in step with en.json and runs in CI.
    Closes #11
    [device_api.cpp, device_api.h, main.cpp, test_main.cpp]
2026-10-11 Add the optional settings PIN (#12) (#27)
    A pure, tested PinGuard holds the PIN (4-8 digits, off by default),
    issues 128-bit session tokens that expire after 12 h idle, and locks
    unlocking out after 5 wrong PINs for 30 s doubling up to 15 min.
    Settings, Calibration, wiring, naming and Wi-Fi changes require a token
    when the PIN is on; Manual control, Stow, the speed slider and reads
    never do. The interface asks for the PIN when needed and retries, and
    Settings can set, change and remove it.
    Closes #12
    [device_api.cpp, device_api.h, main.cpp, pin_http.h, test_main.cpp]
2026-10-11 Add firmware updates from the browser (#13) (#28)
    POST /api/update streams an uploaded app image into the inactive OTA
    slot after checking the ESP image magic and the target chip, and marks
    it bootable only once complete and verified; an interrupted upload
    leaves the running firmware. Protected by the settings PIN. The
    partition table moves to min_spiffs (two 1.9 MB app slots, NVS
    unchanged, 4 MB layout on every chip). Settings gains a Firmware
    update section with upload progress.
    Closes #13
2026-10-11 Add Home Assistant through MQTT discovery (#14) (#29)
    A pure, tested home_assistant library builds the topics, the discovery
    messages (Stow button, per-axis position and maximum speed numbers,
    activity sensor, availability) and parses commands. The firmware's
    MQTT bridge runs in its own task so a slow broker never stalls the
    control loop; commands reach the Robot core under its lock, positions
    through the new Manual control by position (manualGoto), which obeys
    Travel limits, speed and Stow priority. Broker settings live in
    Settings → Home Assistant behind the PIN; MQTT is off by default.
    Closes #14
    [device_api.h, main.cpp, mqtt_bridge.cpp, mqtt_bridge.h, test_main.cpp]
2026-10-11 Add releases and the web flasher (#15) (#30)
    A vX.Y.Z tag runs the release workflow: tests and the language check
    gate it, the three chips build with the tag's version, and a GitHub
    release gets a factory image and an OTA image per chip. The web
    flasher (ESP Web Tools 10.4.0, English and French) is assembled with
    a generated manifest and deployed to GitHub Pages once the repository
    is public; a manual run is a dry run. Builds now take their version
    from git and write factory.bin next to firmware.bin.
    Closes #15
2026-10-11 Add wiring diagrams for a 5 V supply or a USB-C adapter (#31)
    Two SVG diagrams in docs/images show the +5 V and GND rails feeding
    both servos and the board's 5V/VIN pin, the GPIO 18/19 signal wires
    (GPIO 4/5 on S3/C3) and the capacitor across the rails. Electronics
    explains both options, the back-feeding caveat when the board is also
    on a computer's USB, the CC resistors a USB-C breakout needs, and why
    the servos must never draw through the board's own USB port.
2026-10-11 Use a single wiring diagram (#32)
    One 5 V supply feeding both servos and the board is all the robot
    needs; the USB-C variant is dropped to keep the electronics page simple.
2026-10-12 Put installation forward in the README (#40)
    * Put installation forward in the README (#39)
    An install button near the top and in a new Install the firmware
    section, short steps, the beta notice, and updates and source builds
    folded into a details block.
    * README: install steps as a numbered list
    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
2026-10-12 Driver help with download links on the web flasher (#45) (#46)
2026-10-12 Diagnostic report on the Info page (#49) (#60)
    A new pure library, lib/diagnostics, keeps the last 200 log lines, builds
    the report text and redacts personal data (name, hostname, Wi-Fi network,
    IP, MAC, broker, MQTT user and values noted while logging), whole words
    only, including inside log lines. 15 native tests.
    Firmware: every log line goes through logLine() into the buffer, the boot
    line records the reset reason, and GET /api/diagnostics serves the report,
    redacted unless ?full=1. The Info page shows it with Copy, Download and a
    separate full download for local use. Simulator, API docs, features,
    acceptance checklist, SUPPORT.md and the bug form updated.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
    [device_api.cpp, device_api.h, diagnostics_api.cpp, diagnostics_api.h, log.cpp, log.h, main.cpp, mqtt_bridge.cpp]
2026-10-12 Fix Wi-Fi attempts failing instantly (#62) (#64)
    Network::loop() read millis() before Improv or the setup page started an
    attempt; startAttempt() then set modeSince_ to a later millis(), so
    now - modeSince_ wrapped around, exceeded the 20 s timeout and failed the
    attempt in the same pass. Read the clock after the attempts may start.
    The other loops (DeviceApi, MqttBridge) set their reference from the same
    now and are not affected.
2026-10-12 Visible network list on the setup page (#63) (#65)
    The setup page only offered networks through a <datalist>, which phones
    and captive-portal browsers don't show. The robot's scan worked (24
    networks returned on the board). Show them as a tappable list, strongest
    first with signal bars and a lock, preselect the strongest, add Rescan,
    and keep typing for hidden networks.
2026-10-12 Hide the "Not calibrated yet" banner once calibrated (#70) (#75)
    .banner sets display: flex, which beat the browser's [hidden] rule, so
    the banner never hid. A global [hidden] { display: none !important }
    makes hidden win for every element of the Device interface.
2026-10-12 Count the PIN lockout down on screen (#67) (#77)
    The dialog showed the robot's retryAfter once and never updated it. It
    now counts down every second, keeps Unlock and the field disabled until
    the lockout ends, then clears the message. The simulator gains the same
    lockout (5 wrong PINs, 30 s) so the dialog can be tried without a robot.
2026-10-12 Start each Calibration step at the value it sets (#71) (#78)
    Steps used to start wherever the wand was left. Entering a step now
    moves its axis, at Calibration speed, to the draft's current value for
    that step (current Travel limits, or the defaults on a first
    Calibration, both known safe); the Stow step moves both axes to the
    current Stow position.
2026-10-12 Clearer Calibration wizard: step names, marked values, limits (#69) (#79)
    Steps are named after what they set (Horizontal minimum, ...), and the
    texts say the wand first moves to the current value and which way to
    nudge. A "Marked so far" box recalls earlier steps, the Stow step shows
    each axis's allowed range, and a maximum below the minimum names the
    minimum in the error.
2026-10-12 Explain the servo pulse range in Settings → Wiring (#72) (#80)
    The pulse fields read as a speed setting. They now sit in a collapsed
    "Servo travel (advanced)" section per axis, explaining that they set how
    far the servo turns, not how fast, when to widen or narrow them, the
    defaults and a Reset to default link. A wrong value opens the section.
2026-10-13 Continue without Wi-Fi from the hotspot setup page (#82) (#83)
    The setup page gains a "Continue without Wi-Fi" button that opens the
    main screen through the hotspot, for the rest of the tab. Settings gains
    a Wi-Fi section with the connection state and, while on the hotspot, a
    "Connect to Wi-Fi" link back to the setup page. Firmware unchanged.
2026-10-13 Split Settings into Motion, Hardware, Network and Robot tabs (#84) (#85)
    Settings was one long page of eight sections. They now sit in four tabs
    declared in one TABS list in settings.js, with the open tab in the URL
    hash, the ARIA tab pattern and arrow-key navigation. Motion gets a
    visible Run Calibration button; Robot gains a link to Info. Docs now
    name the tab in every Settings path.
2026-10-13 README as a hub: presentation, specs, Firmware/Electronics/Hardware boxes (#89) (#90)
    The README now leads with the presentation and the spec links, keeps a
    placeholder for photos and a demo video, and has three short boxes for
    building one: Firmware (install principle, flasher and docs), Electronics
    (compact BOM and diagram) and Hardware (compact BOM, printing). The details
    move to docs: install.md (install and first start), hardware.md (printed and
    mechanical parts, print settings), electronics.md gains its parts list, and
    assembly.md becomes the assembly guide, marked as coming soon with the draft
    order folded away.
2026-10-13 Calibration: explain min/max with the joystick and reverse the axis in place (#87) (#91)
    Each Travel limit step now says which joystick position it matches
    (minimum = fully left or down, maximum = fully right or up) and offers
    "Reverse this axis" with a hint for when - moves the arm the wrong way.
    Reversing is a new Calibration action. The Robot core mirrors every angle of
    the axis (a -> 180 - a: position, draft, saved settings, remembered resting
    position) while the servo driver flips its direction, so the same pulse keeps
    going out and the wand does not move. Calibration is kept, the wiring is
    saved with the new direction, no restart is needed, and the axis starts over
    at its minimum step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
    [device_api.cpp, servo_driver.cpp, servo_driver.h, test_main.cpp]
2026-10-13 Remove the retired Mk1 STL archive (#92) (#93)
    The Mk1 is retired and the firmware only targets the Mk2. The files stay in
    the Git history; CONTEXT.md says so.
    [CLAMP - Clamp.stl, CLAMP - Pad.stl, CLAMP - Screw.stl, CLAMP - Screw_pad.stl, Part Studio 1 - Part 2.stl, Part Studio 1 - Part 3.stl, Servo support.stl, Stick support.stl]
2026-10-13 Explain how to update the firmware from the hotspot (#94) (#96)
    Phones open hotspot pages in a captive-portal sign-in window that has no file
    picker, so the firmware file could not be chosen. In hotspot mode, Settings
    -> Robot -> Firmware update now says to open the robot's address in the
    regular browser, with the address and a Copy button; the setup page says the
    same under Continue without Wi-Fi.
2026-10-13 Calibration: Recalibrate and Cancel the new Calibration when one is saved (#95) (#97)
2026-10-13 Help page with a prefilled issue (#50) (#98)
    A Help page, linked from Settings -> Robot and the Info page. "Ask a
    question" opens Discord. "Report a problem" takes a description, shows the
    exact text that will be public (description + redacted Diagnostic report),
    then opens GitHub's bug form prefilled with the description, the report (the
    most recent log lines that keep the URL under 7,000 characters), the firmware
    version and the chip, and downloads the whole report to attach. It points to
    Discord for people without a GitHub account and to SECURITY.md for
    vulnerabilities. Support links live in web/links.js.
2026-10-13 Help links at every entry point (#52) (#99)
    - Device interface: "Need help?" after 10 s without connection, after a
    failed firmware upload and after a failed Wi-Fi setup, leading to Help.
    - Web flasher: Discord and SUPPORT.md next to the driver help (EN + FR).
    - Docs: getting started and Home Assistant link to SUPPORT.md; the HA doc
    explains that discovery allows one link per device (Visit -> interface).
    - Release notes start with a "Found a problem?" line.
    - Narrow phones show only the connection dot, so the robot's name is no
    longer split over two lines.
2026-10-13 Pending report: save a problem on the hotspot, send it once online (#51) (#100)
    - lib/diagnostics/pending: keeps one report in flash (description up to
    600 characters + redacted report, the oldest log lines dropped to fit
    3 KB). Native tests first (6 cases).
    - GET/PUT/DELETE /api/diagnostics/pending; the robot builds the redacted
    report itself on PUT.
    - Setup page: "A problem?" with the report download and the Discord
    address. Help: "Save for later" when the robot is on its hotspot; a
    "Saved report" section to review and send, or discard.
    - Main screen: a banner once the robot is on the owner's network. Never
    sent by itself.
    - CONTEXT.md: Pending report. Docs, checklist, simulato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
    [diagnostics_api.cpp, diagnostics_api.h, test_main.cpp]
2026-10-13 Stack the Info and Help links in Settings → Robot (#102) (#103)
2026-10-13 Calibration: "Reverse this axis" is a checkbox showing the wiring (#101) (#106)
2026-10-13 Support relay: report to issue (#54) (#107)
    Cloudflare Worker in relay/ turning a redacted Diagnostic report into a
    GitHub issue as a GitHub App: CORS for Device interface origins, format and
    size checks, per-IP rate limit, daily cap, kill switch. Tested in CI,
    deployed by the Support relay workflow. The Diagnostic report gains a random
    Device ID so reports from one robot can be grouped.
    [diagnostics_api.cpp, test_main.cpp]
2026-10-13 Support relay: report which GitHub step failed (#54) (#108)
2026-10-13 Send to support from the robot (#55) (#110)
    Help offers "Send to support" through the Support relay when it answers /status, with an optional contact, and shows the created issue link. A pending report sent this way is removed. Any relay failure falls back to the prefilled GitHub issue.
2026-10-13 Support relay on Discord: follow a report, /issue, release notifications (#56, #57, #58) (#111)
2026-10-13 /issue twice no longer creates a duplicate before GitHub search indexes the first one (#57) (#116)
    Found on the live server: two /issue a few seconds apart created #114 and #115. The relay now looks for its own earlier "tracked in" answer in the thread before searching GitHub.
2026-10-13 Help: after "Send to support", show only the issue and Discord thread links (#124) (#125)
2026-10-13 Minimum speed per axis: the speed slider runs from minimum to maximum (#127) (#131)
    Settings record v2 with a v1 migration that keeps 0.1.0 settings and Calibration.
2026-10-13 Project website: MkDocs site from README + docs, flasher moved to /flasher/ (#129) (#132)
    - website/prepare_docs.py stages README (home), docs/, SUPPORT/SECURITY/CONTEXT
    and media/ into website/build/docs, rewriting repo links for the site
    (non-page files go to github.com, GitHub alerts become admonitions).
    - website/mkdocs.yml: MkDocs Material, tabs Home/Install/Firmware/Electronics/
    Hardware/Use/Community, mkdocs-static-i18n suffix layout (en only for now),
    strict link and anchor validation; versions pinned in website/requirements.txt.
    - flasher_site.py writes the flasher page, its logo, channels and
    channels.json under <site>/flasher/; tests updated.
    - New Pages workflow builds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
2026-10-14 Website in French: translated user pages, language switch, translation check (#130) (#141)
    - README.fr.md (French home), SUPPORT.fr.md and docs/*.fr.md for every
    user page, in French with tutoiement and the Device interface's terms.
    - mkdocs-static-i18n suffix layout: language switch keeps the page,
    French search, translated nav; contributor docs fall back to English.
    - website/check_translations.py (+ test) fails CI when an English user
    page has no .fr.md; run in pages.yml.
    - AGENTS.md: update the French page in the same PR.
    - README status: v0.1.0 stable.
2026-10-14 Play session: Robot core, settings and API (#138) (#142)
    * Play session: Robot core loop, Random port, settings v3 (#138)
    Each Axis runs its own move/pause loop: a target drawn uniformly over the
    Travel limits, a speed over the Speed range, a pause over the new Pause
    range. Time up, Stop and Stow end it with Stow; Manual control ends it
    without Stow. Settings record v3 adds the Pause range per axis and the
    Session duration, migrated from v2.
    * Play session: API, simulator and docs (#138)
    POST/GET /api/play (no PIN), sessionMinutes in /api/settings settable
    without the PIN like playSpeed, Pause range in /api/settings behind the
    PIN, /ws activity 'playing' with play.remaining, MQTT activity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
2026-10-14 CI: move actions to Node 24, pin runners to ubuntu-24.04 (#134) (#143)
    Bump actions/deploy-pages v4->v5 and upload-pages-artifact v3->v5, and
    the first Node 24 major of every other action (checkout v5, setup-python
    v6, cache v5, setup-node v5, upload-artifact v6, download-artifact v7,
    wrangler-action v4, action-gh-release v3), skipping later majors with
    breaking changes. Pin runs-on to ubuntu-24.04 so the ubuntu-latest move
    to Ubuntu 26.04 cannot break the required checks unannounced.
2026-10-14 Play session in Home Assistant: switch and Session duration number (#140) (#144)
    MQTT discovery announces a Play session switch (state from the Activity)
    and a Session duration number (1-60 min). The state payload carries
    play ON/OFF and sm; the bridge maps ON/OFF to start/stop and validates
    whole minutes. Docs, API and acceptance checklist in EN and FR.
2026-10-14 README: inline Mk2 video and a link to the website for beginners (#146)
    GitHub plays the user-attachments video inline; the website staging turns
    it into a <video> of the media/ copy and drops github-only blocks such as
    the new 'read it on the website' tip.
2026-10-14 Play session: Device interface (#139) (#147)
    Main screen: a Play session block under the speed slider with the
    Session duration (− / number / +, 1–60 min, saved through
    PUT /api/settings {sessionMinutes}), Start, and while playing Stop with
    a smoothly ticking time left from /ws play.remaining. It follows /ws, so
    sessions started elsewhere or ended by the joystick show up; errors are
    shown, not_calibrated with a link to Calibration.
    Settings → Motion: Pause range min/max per axis, saved with the PIN.
    Docs: features, README summary and the acceptance checklist describe
    the UI; the French pages get the Play session content #138 added in
    English (features, api, acceptance checklist).
    Co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
2026-10-14 Docs: ready-made Home Assistant dashboard (#135) (#149)
    Built-in cards only: Play session switch and duration, Stow, Activity,
    positions and maximum speeds, EN + FR. A website test checks the YAML
    parses and targets every announced entity.
2026-10-14 Docs: one page per topic, dedicated Home Assistant setup guide (#150) (#151)
    Build tab in order: print, assembly (with parts to buy), wiring, install.
    Home Assistant tab: a 6-step guide from prerequisites to the device,
    then dashboard, automations, troubleshooting. Old URLs redirect. The
    robot's Home Assistant settings link to the guide.
2026-10-14 ADR 0010: the Native integration authenticates with the Settings PIN (#152) (#155)
2026-10-14 Native integration discovery: _catwandconnect._tcp, API version, POST /api/position (#156) (#164)
    - lib/discovery (native-tested): kApiVersion = 1, the mDNS service name
    and the TXT record set (id, api, version, name).
    - The robot advertises _catwandconnect._tcp on port 80 beside _http._tcp.
    - GET /api/info returns api and id (Device ID).
    - POST /api/position {"axis","degrees"}: Manual control by position, as
    the MQTT position command; 400 invalid_request on a bad axis or a
    non-number; no PIN.
    - dev_server.mjs mirrors the new fields and route.
    - docs/api (EN+FR): API version and versioning rule, discovery, the new
    route; acceptance checklist and features updated; CONTEXT: API version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
2026-10-14 Home Assistant guide: Native integration and MQTT connection, a dashboard each (#162) (#165)
    docs/home-assistant(.fr).md now opens with "Choose your connection"
    (comparison table + a warning not to use both on one robot: two devices,
    _2 entity ids), then the Native integration (HACS custom repository,
    restart, add from Discovered or by host, PIN, firmware too old,
    reconfigure on a new PIN), the MQTT connection's six steps as a
    subsection, one ready-made dashboard per connection (marker
    <!-- ha-dashboard-native --> beside <!-- ha-dashboard -->), automations
    and troubleshooting split per connection.
    website/test_ha_dashboard.py checks both dashboards in both languages:
    each uses only, and all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
2026-10-14 Dashboards: Play session as a big toggle button (#168)
    Owner request during the 0.2.0-beta.2 test session: the tile's toggle looked
    like a push button. The switch entity is unchanged.
2026-10-14 Calibration ends with Speed tuning: minimum and maximum speed per axis (#170) (#171)
    After saving the limits, the wizard chains /api/speed-tuning for each
    axis's minimum and maximum speed (each skippable), then a Done step.
    Page-only: no Robot core or API change.
2026-10-14 Settings → Network: Change Wi-Fi network button and IP address (#174) (#178)
    Settings → Network shows the network, IP and .local address with a
    Change Wi-Fi network button (warning + confirm) that reuses the setup
    page. POST /api/wifi is now accepted from the home network too; a failed
    change rejoins the previous network before opening the hotspot
    (lib/wifi_fallback, ADR 0011). Status gains hotspot and failedSsid.
    [test_main.cpp]
2026-10-14 Calibration: Acceleration tuning after each axis's maximum speed (#172) (#179)
    Robot::startAccelTuning() runs Speed tuning in an acceleration mode: short
    back-and-forth moves across the middle half of the Travel limits, each from
    a stop, at the axis's maximum speed; adjust/keep/cancel reuse Speed tuning
    (steps 20/50/100 °/s², bounds 20-2000, keep saves maxAccel).
    POST /api/speed-tuning accepts "target":"accel"; the state carries target and
    accel. Calibration wizard order per axis: min speed, max speed, acceleration
    (Step n of 12); Speed tuning page offers it too. EN/FR strings, docs,
    CONTEXT term, checklist, changelog; simulator follows.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
    [device_api.cpp, test_main.cpp]
2026-10-15 Add one-tap firmware update from the Device interface (#187)
    The browser reads the Update feed (flasher/channels.json on GitHub Pages),
    downloads the OTA image for the robot's chip family and uploads it to
    POST /api/update; the robot stays without outbound connections (ADR 0012).
    The Update channel becomes a persistent robot setting, the main screen shows
    an update banner, and the MQTT Firmware update entity reports latest_version.
    Closes #185
2026-10-15 Device interface: first-visit home-screen tip on phones (#189) (#190)
    On a phone's first visit, a dialog explains how to add the robot's page
    to the home screen (iOS Safari Share or Android Chrome menu), with inline
    SVG illustrations. Got it hides it for good, Later at most once a day;
    Help reopens it. Not shown on desktop, on the hotspot, when standalone,
    or when an update is offered.
2026-10-15 Device interface: offer the .local address first when opened by IP (#191) (#192)
    Opened by IP, the main screen checks whether this device resolves the
    robot's .local name (an <img> probe of icon-192.png, 3 s timeout). If it
    does, a "Use the robot's permanent address" step offers Go (same path on
    .local, where the home-screen tip then shows) or Not now (tip on the IP
    page, step again at most once a day). If it doesn't, the tip shows with a
    hint to reserve the address in the router. Desktop gets only the step.
    Settings -> Robot gets "Add to your home screen". The simulator's
    LOCAL_HOST stands in for a resolving .local name.
2026-10-16 Docs: USB-C PD power chain and example parts (#198)
    Wiring guide, README and diagrams now show the reference power chain:
    USB-C PD charger (30 W min, 45 W recommended) -> PD trigger board set
    to 20 V -> buck converter set to 5 V -> +5 V/GND rails, with a safe
    set-up order, example AliExpress parts, and the DS3218 servo upgrade.
    Closes #197
2026-10-16 Wiring guide: step-by-step electronics build for the reference build (#201) (#202)
    Add 'Build it step by step' to docs/wiring.md (+ .fr): solder the power
    boards, check 20 V / 5 V, wire both servos and the board through two
    Wago 221-style lever connectors and cut servo extension cables. Add the
    lever connectors, extension cables, wire and tools to the parts list.
    Move the owner's mechanical steps (boards on top, wires into the clamp's
    technical cavity) to the Mechanism assembly draft. README no longer says
    no soldering is needed.
2026-10-16 Assembly draft: don't guess where the lever connectors sit (#203)
2026-10-16 Wiring guide: electronics only, 2-port lever connectors, table-top first test (#206)
2026-10-16 Default-named robots get a unique .local hostname; set-up robots keep theirs (#195) (#207)
    A robot that keeps the default name now answers at catwandconnect-<4 hex of
    the Device ID>.local, so two robots no longer clash. Robots that already had
    Wi-Fi credentials at the first boot of this firmware keep catwandconnect.local
    (decided once, stored in NVS). MQTT entity ids keep the name-based prefix and
    unique ids stay MAC-based, so Home Assistant entities don't change.
    [device_api.cpp, device_api.h, main.cpp, mqtt_bridge.cpp, test_main.cpp]
2026-10-17 Print guide: no supports except under the clamp's horizontal surfaces (#210)
2026-10-17 Add the Mk3 Mechanism as the current reference (#211)
    The Mk3 is standalone: the board and the USB-C power chain sit inside
    the clamp's technical cavity, closed by a new printed door, with a
    single USB-C connector. Its seven parts and plate go in stls/mk3/ with
    the Mk2 naming; the Mk2 stays in stls/mk2/ as the previous Mechanism.
    Docs (EN+FR), CONTEXT.md, the bug form and the changelog now point to
    the Mk3. The assembly draft is flagged as written for the Mk2 and not
    yet checked on the Mk3.
    [catwandconnect-mk3-arm.stl, catwandconnect-mk3-bearing.stl, catwandconnect-mk3-clamp.stl, catwandconnect-mk3-door.stl, catwandconnect-mk3-rotor_plate.stl, catwandconnect-mk3-screw.stl, catwandconnect-mk3-top_plate.stl, catwandconnect-mk3.3mf]
2026-10-17 Mk3: updated bearing and rotor plate (#212)
    [catwandconnect-mk3-bearing.stl, catwandconnect-mk3-rotor_plate.stl]
2026-10-17 Mk3: updated .3mf plate (new bearing and rotor plate) (#213)
    [catwandconnect-mk3.3mf]
2026-10-18 Mk3 parts list: 27-28 balls of 6 mm (airsoft BBs work) (#214)
2026-10-18 Mk3: rename the bearing part to bearing_holder (#215)
    [catwandconnect-mk3-bearing_holder.stl]
2026-10-18 Mk3: corrected clamp, updated .3mf plate, print plate picture (#216)
    [catwandconnect-mk3-clamp.stl, catwandconnect-mk3.3mf]
2026-10-18 Mk3: updated clamp, top plate and .3mf plate (#217)
    [catwandconnect-mk3-clamp.stl, catwandconnect-mk3-top_plate.stl, catwandconnect-mk3.3mf]
2026-10-19 Docs: five-step build quickstart, one guide template, full parts list; retire the Mk2 (#219)
    * README: presentation, sponsor button, video and gallery, five-step quickstart (#218)
    * Docs: full parts list and one template for every build guide; Mk3 print and assembly steps (#218)
    * Retire the Mk2: remove its files and mentions (#218)
    * Website: build order in the nav, full-width video; changelog (#218)
    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
    [catwandconnect-mk2-arm.stl, catwandconnect-mk2-bearing.stl, catwandconnect-mk2-clamp.stl, catwandconnect-mk2-rotor_plate.stl, catwandconnect-mk2-screw.stl, catwandconnect-mk2-top_plate.stl, catwandconnect-mk2.3mf]
2026-10-19 Install button the same size as the sponsor button (#220)
2026-10-19 Documentation button in the README, website menu on the web flasher (#221)
2026-10-20 Publish the Mk3 CAD sources as STEP files (#228) (#229)
    One STEP file per part and one for the whole Mechanism, exported from
    Onshape, in cads/mk3/ (already licensed CERN-OHL-S-2.0 by LICENSE.md).
    The print and getting-started guides (EN/FR) point to them.
    [catwandconnect-mk3-arm.step, catwandconnect-mk3-bearing_holder.step, catwandconnect-mk3-clamp.step, catwandconnect-mk3-door.step, catwandconnect-mk3-rotor_plate.step, catwandconnect-mk3-screw.step, catwandconnect-mk3-top_plate.step, catwandconnect-mk3.step]
2026-10-20 Assembly: M3 screw lengths and head types (#230) (#231)
2026-10-21 Link previews: social preview image for the repo, the website and the web flasher (#235)
    * GitHub social preview image from the new banner (#234)
    * Link previews for the website and the web flasher (#234)
    Open Graph and Twitter card tags on every website page (via a Material
    override) and on the flasher, pointing at media/social/social-preview.png.
    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
2026-10-23 Docs: power wire lengths for the reference build (#241) (#242)
2026-10-23 HA dashboards: open the robot's page from a button or a long press (#237) (#243)
    Both ready-made dashboards (Native integration and MQTT, EN and FR) get a
    "Robot page" button badge in the Play session heading, and a long press on
    every tile and button opens the robot's page instead of more-info. The YAML
    uses http://catwandconnect.local/ as a placeholder; the guide's new step 4
    says where to find the robot's address (Settings -> Network -> Wi-Fi).
    website/test_ha_dashboard.py checks the badge, the hold actions and that
    every url action uses the placeholder the guide names.
2026-10-23 Home Assistant: Play session end sensor over MQTT (#236) (#244)
    * Home Assistant: Play session end sensor over MQTT (#236)
    The MQTT connection gets a "Play session end" sensor (device_class
    timestamp). The robot has no wall clock, so it publishes the time left in
    whole seconds on <base>/play_session/remaining (retained, "0" when no
    session runs) and the discovery value_template adds it to Home Assistant's
    clock; a rendered "None" reads as unknown.
    PlayRemainingReporter (lib/home_assistant, native tests) sends it only when
    a session starts or ends, when its end moves by more than 2 s, on connection
    and when Home Assistant comes back online (homeassistant/status), never
    every second.
    Docs: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
2026-10-23 Wiring guide: step-by-step photos, three extension cables (#246)
    The build steps follow the reference build's order (extension cables,
    soldering, lever connectors, board, power test), each with its photo;
    paired steps show their photos side by side.
2026-10-23 Wiring guide: embed the wiring tutorial video (#247) (#248)
    On the website: a YouTube (no-cookie) player at the top of the guide.
    On GitHub, which strips iframes: a clickable thumbnail.
2026-10-26 Wiring guide: simpler, shorter, details collapsed (#255)
    * Wiring guide: simpler, shorter, details collapsed (#253)
    What you need trimmed to the essentials, three rules, the reference
    steps with shorter text, and everything else (example parts, DS3218,
    other options, generic wiring, power chain, rules, pins, pulse range)
    in <details> blocks. Every anchor other pages link to is kept.
    * Install guide: tutorial video, 9 illustrated steps (#256)
    * Install guide: tutorial video and 8 steps matching it (#254)
    * Install guide: the owner's photos and screenshots, flashing split in two steps (#254)
    20 images (4 photos as JPEG in media/photos, 16 screenshots as PNG in
    media/screenshots), named in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
2026-10-26 README and website: Join the Discord button, community message (#257) (#259)
2026-11-05 README: robot video in See it, three vertical video slots (#260) (#261)
    On the website: YouTube no-cookie player 9:16 plus two dashed
    "More videos soon" slots, through a new website-only block that
    prepare_docs.py unwraps (hidden in an HTML comment on GitHub). On
    GitHub: a 3-cell table with the clickable thumbnail.
